AI-go-do/mspace-device/README.md

# mspace-device

M-SPACE 디바이스·센서 서비스예요. **문 앞 QR 입실**과 **방 안 재실 센서**를 맡아요.

- 담당: 수연
- 팀 공통 문서: [AI-go-do/docs](https://github.com/AI-go-do/docs) (요구사항·컨벤션·인프라)

## 1. 관련 요구사항

| ID | 내용 | 버전 |
|---|---|---|
| FR-ACC-001 | 입실 번호 확인 → 체크인 (키패드·QR 두 방식을 만들어 비교한 뒤 QR 채택, 11/10부터 QR 하나) | v0.1 |
| FR-DEV-101 | 재실 센서 값 수집 (레이더·조도·CO2 → 서버) | v0.2 |
| FR-DEV-102 | 방 현황 화면 (지금 비었는지, 다음 예약) | v0.2 |
| FR-DEV-103 | 자리 비움 자동 퇴실 (10분 비면 알림, 15분이면 퇴실. 앱의 "아직 있어요"는 예약당 1번, 누른 뒤 10분 비면 퇴실) | v0.2 |
| FR-DEV-104 | 환기 알림 (CO2 1000ppm) | 확장 (10차: 방 사용자에게 바로) |
| FR-DEV-105 | 퇴실 뒤 정리 확인 (방 카메라). 10차: 종류 구분 없이 "두고 갔다"만, 3시간 안에 안 가져가면 경고(회의는 2시간, 11/10 core #113에서 3시간) | v0.3 |
| FR-DEV-106 | 가상 에어컨·공기청정기 자동 제어 (파사드·어댑터) | v0.3 (10차) |
| FR-DEV-107 | 시나리오 시뮬레이션 (예약 → 입실 → CO2 상승 → 기기 자동 켜짐) | v0.3 (10차) |

## 2. 전체 구조

```mermaid
flowchart LR
    qr[문 앞 웹캠 QR] --> gw
    sensor[PIR · 조도] --> uno[우노]
    uno -- USB 시리얼 --> gw[중계<br/>노트북 또는 젯슨]
    gw -- HTTPS --> core[예약 서버 core]
    core -- OK / NO --> gw
    gw -- OK / NO --> uno
    uno --> led[초록 · 빨강 LED]
    radar[레이더] --> esp[ESP32<br/>메인 장치]
    esp -- 와이파이 HTTPS --> core
```

- 우노는 와이파이가 없어서 USB로 노트북에 보내고, 노트북(`gateway/gateway.py`)이 서버에 대신 전달해요.
- **ESP32가 메인 장치예요.** 노트북 없이 ESP32 → 서버로 바로 보내요. 보내는 형식이 같아서 서버는 바뀌지 않아요. 지금은 우노+젯슨(1번 방)과 ESP32(2번 방)를 같이 시험해요.
- 번호가 맞는지는 **서버만 판단**해요. 장치는 번호를 저장하지 않고, 읽은 번호를 보내고 결과를 표시만 해요.

## 3. 진행 상황 (11/11 기준)

### 지금까지 한 것

| 영역 | 한 것 | PR |
|---|---|---|
| 출입 | 키패드(#1, #25)와 문 앞 웹캠 QR(#26) 두 방식을 만들어 비교했고, 번호를 누르지 않아 더 빠르고 간편한 QR을 채택 (11/10). QR → core 확인 → 우노 LED | #1, #20–#22, #25, #26, #43, #44 |
| 재실 | PIR·조도 → `POST /api/sensor-events`, PIR 2분 유지, 방 안 카메라 인원 세기 + PIR 합치기, 조도 같이 보내기 | #24, #27, #35 |
| 정리 확인 | 퇴실 뒤 빈 방 물건 비교, 입실 직전 빈 방을 기준으로, 책상 확대·사진 비교, 이름 겹침 정리, 두고 간 물건은 종류 구분 없이 `LEFT_ITEMS` + 나중에 다시 확인, 의자 같은 가구 빼기, 책상 비교 예민도 설정(`DESK_LIGHT` 등), 바닥 확대(`FLOOR_AREA`) | #27, #28, #29, #32, #42, #47, #48, #49 |
| 정리 사진 | 사람 없는 빈 방 사진(입실 전·퇴실 뒤·다시 확인)을 core에 올리기 (`TIDY_PHOTOS=1`, 기본 꺼짐) | #51 |
| 공기 | 교육장 MQTT 센서(구독만) → 방 CO2·온도·습도, 가짜 센서(젯슨 안 브로커만)와 방 여러 개 | #33, #36 |
| 품질 재기 | 정리 확인 채점·후보 비교 도구 (정확도·심각한 오류·사진당 시간·메모리), 잘못 신고·놓침 나누기, 목표 시간 10초, 깨끗함/남음 정확도로 순위. 1~10판 결과는 9절 | #37, #45, #50, #53, #46, #52, #54 |
| 운영 | 젯슨 켜지면 자동 실행(systemd), 브라우저로 카메라 화면 보기, CI | #18, #19, #27 |
| 설계 | 가짜 센서 방마다 1대, 센서 어댑터 공통 모양 명시 | #38, #39 |

### 설계 패턴 (발표용)

```mermaid
flowchart LR
    subgraph 들어오는 값 - 어댑터
        uno[우노 PIR·조도<br/>시리얼 한 줄] --> a1[occupancy_body]
        cam[방 카메라<br/>YOLO 인원] --> a2[RoomWatcher.event]
        mqtt[실습실·가짜 센서<br/>MQTT JSON] --> a3[RoomEnv.tick]
    end
    a1 & a2 & a3 --> push[push 한 곳<br/>같은 모양] --> core[core<br/>POST /api/sensor-events]
    core2[core<br/>"2번 방 에어컨 켜"] --> facade[기기 파사드<br/>문 하나]
    subgraph 나가는 명령 - 파사드 뒤 어댑터
        facade --> v[가상 에어컨·공기청정기]
        facade -.-> lg[LG 어댑터]
        facade -.-> ss[삼성 어댑터]
    end
```

- **센서는 어댑터 패턴:** 센서마다 들어오는 모양이 달라도 어댑터가 core 이벤트 한 모양으로 바꿔요(`gateway/sensor_adapters.py`). 가짜 센서 ↔ 실습실 센서 ↔ 실제 방 센서를 설정만 바꿔 끼우고, core 코드는 그대로예요. 새 센서는 어댑터 하나 + 표 한 줄이에요.
- **기기는 파사드 패턴:** core는 파사드 하나에 명령만 보내요. 기기마다 다른 조작은 뒤의 어댑터가 맡아서, 기기 종류가 늘어도 `if LG … else if 삼성 …`이 늘지 않아요(FR-DEV-106).
- **품질은 숫자로:** 같은 시험 사진으로 모델·방법을 바꿔 가며 정확도를 재고, 채택하지 않은 후보도 9절에 남겨요.

## 4. 배선도 · 회로도

**꽂기 전에 (고장 안 나게)**
1. USB를 뽑은 상태에서 배선하고, 다 꽂은 뒤 확인하고 연결해요.
2. 5V와 GND를 직접 잇지 않아요 (합선).
3. LED는 꼭 220Ω 저항을 거쳐요. 긴 다리(+)가 핀 쪽, 짧은 다리(−)가 GND 쪽이에요.
4. D0, D1은 비워 둬요. 노트북과 시리얼로 대화하는 핀이에요.
5. 부품은 하나씩 추가하고, 추가할 때마다 시리얼 모니터로 확인해요.

**배선도** (어디에 꽂나)

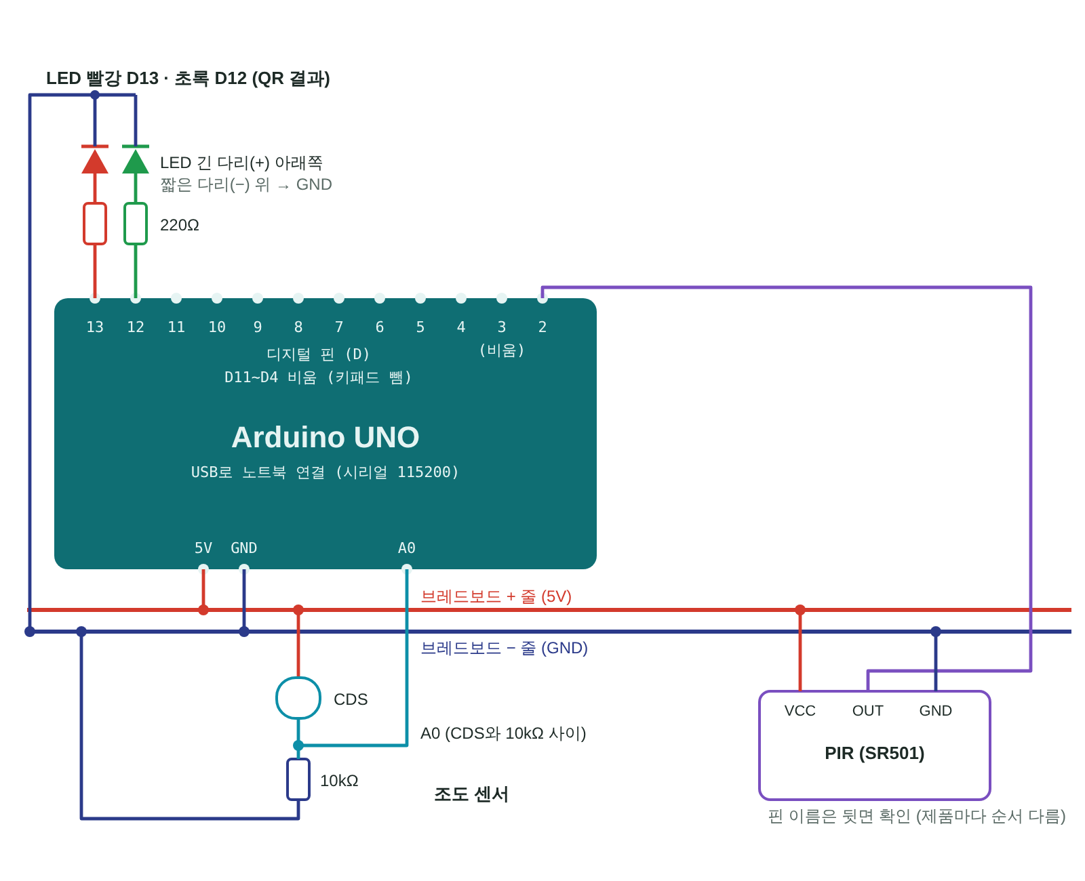
[picture p1: docs/wiring.png]
배선도


**회로도** (무엇이 무엇과 이어지나)

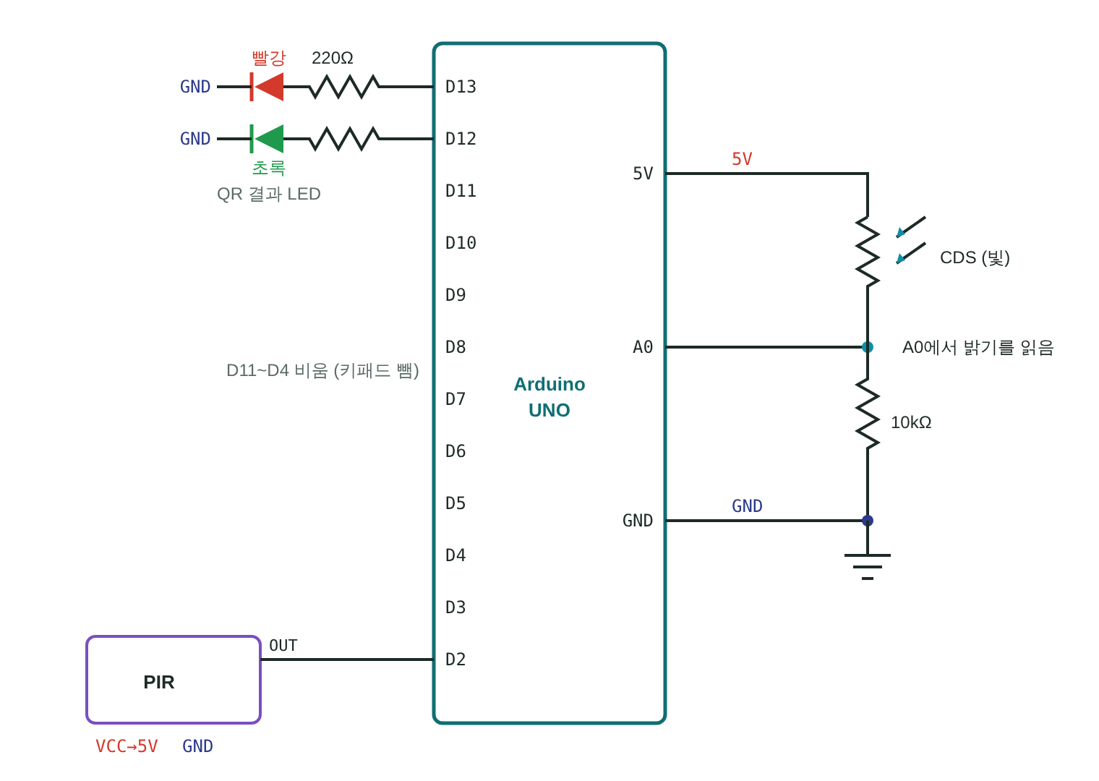
[picture p2: docs/schematic.png]
회로도


| 부품 | 우노 핀 |
|---|---|
| 초록 LED (맞음) | D12 → 220Ω → LED → GND |
| 빨강 LED (틀림) | D13 → 220Ω → LED → GND |
| PIR (SR501) | VCC → 5V, GND → GND, OUT → **D2** |
| 조도 (CDS) | 5V → CDS → **A0** → 10kΩ → GND (CDS와 10kΩ 사이를 A0에) |
| 레이더 (LD2410C) | 우노가 아니라 **ESP32**에 달아요 (아래 "ESP32 방 장치") |

D11~D4는 비워 둬요. 키패드와 QR을 비교한 뒤 QR을 채택해서 11/10에 키패드 배선을 뺐어요.

## 5. 실행 방법

1. `firmware/uno_sensor_node/uno_sensor_node.ino` 업로드 (따로 설치할 라이브러리 없음)
2. 시리얼 모니터(115200)에서 occupancy JSON이 10초마다 찍히는지 확인 → **모니터를 닫아요** (중계와 포트를 같이 못 써요)
3. 중계 실행
   ```bash
   pip3 install -r gateway/requirements.txt
   DRY_RUN=1 python3 gateway/gateway.py              # 서버 없이 테스트 (보낼 내용만 화면에)
   echo 'DEVICE_TOKEN=<받은 장치 토큰>' > .env   # 토큰은 .env에만 (저장소에 안 올라가요)
   set -a; . ./.env; set +a                          # .env 값을 불러오기
   SERVER=https://dev-mspace.java21.net python3 gateway/gateway.py   # 토큰이 실리므로 원격 서버는 https만
   SEND_SENSORS=1 SERVER=https://dev-mspace.java21.net python3 gateway/gateway.py   # 재실 센서도 core로 보내기
   ```
   재실 센서 전송(`SEND_SENSORS=1`)은 core에 `/api/sensor-events`(core #60)가 올라간 뒤 켜요. QR 확인을 막지 않게 뒤에서 보내고, 끊기거나 토큰·경로 문제(401·403·404)면 모아 뒀다가 다시 보내요(최대 360개, 약 1시간). 이벤트 자체가 틀린 것(400·409·413·422)만 버려요.
   포트는 자동으로 찾아요. 못 찾으면 `PORT=/dev/ttyACM0`처럼 지정해요.
   서버에는 `Authorization: Bearer <장치 토큰>` 헤더로 보내요. 토큰이 없으면 DRY_RUN만 돼요.
   `http://`는 내 컴퓨터에 띄운 core 테스트에서만 써요. 원격 주소에 `http://`를 쓰면 게이트웨이가 시작하지 않아요(토큰 보호).

### QR 입실 (문 앞 웹캠, 시연용)

키패드와 카메라 QR 두 방식을 모두 만들어 비교했어요. QR이 번호를 누를 필요가 없어 더 빠르고 간편해서 8차 회의(11/6)에서 **카메라 + QR**을 채택했고, 11/10에 키패드 코드를 정리했어요. 입실은 이 QR 하나로 서버 확인(`/api/access/verify`)을 해요.

```bash
ls /dev/video*                                    # 웹캠 번호 확인 (보통 0)
set -a; . ./.env; set +a
QR_CAMERA=0 SEND_SENSORS=1 python3 gateway/gateway.py          # 진짜 서버
DRY_RUN=1 QR_CAMERA=0 python3 gateway/gateway.py               # 서버 없이: 123456 QR만 초록
```

- 흐름: 폰에 QR 띄우기 → 문 앞 웹캠에 비추기 → 젯슨이 읽어 core에 확인 → 우노 LED 초록/빨강
- QR 안의 글자: 입실 번호 6자리(`123456`) 또는 방까지 넣은 `MSPACE:1:123456`. 방 번호는 `QR_ROOM_ID`(기본 1). 다른 방 QR은 서버에 묻지 않고 거부
- 지금은 예약 때 받은 6자리 번호를 QR로 만들어 비춰요 (QR 만들기 사이트나 앱). 나중에 웹 입실 화면이 QR을 바로 띄우고, core가 "30초마다 바뀌는 코드"를 주면 `qr_door.py`의 `parse_qr()`만 바꾸면 돼요
- 같은 QR을 계속 비추면 5초 동안은 다시 묻지 않아요
- **사진·영상은 저장하지도 보내지도 않아요.** 읽은 글자만 써요
- OpenCV(`cv2`)는 젯슨에 기본으로 깔려 있어요. 없다고 나오면 `sudo apt install python3-opencv`

### 방 안 카메라 (인원 세기 · 정리 확인, 시연용)

방 안을 비추는 두 번째 웹캠으로 **몇 명 있는지** 세고, 사람이 다 나가면 **방이 깨끗한지** 확인해요.

```bash
# 처음 한 번: 사람·물건 찾는 모델 받기 (yolov8s.onnx, 약 45MB)
# 작은 n(12MB)은 빠르지만 위에서 내려다본 노트북·폰을 자주 놓쳐서 s를 써요
pip3 install ultralytics && yolo export model=yolov8s.pt format=onnx opset=12
mv yolov8s.onnx gateway/

# 젯슨 기본 OpenCV(4.6)는 YOLOv8 모델을 못 읽어서 onnxruntime을 같이 써요 (처음 한 번)
sudo apt install -y python3-opencv python3-numpy python3-venv
python3 -m venv --system-site-packages ~/mspace-venv     # apt로 깐 OpenCV·serial은 그대로 씀
~/mspace-venv/bin/pip install onnxruntime

set -a; . ./.env; set +a
ROOM_CAMERA=2 YOLO_MODEL=gateway/yolov8s.onnx SEND_SENSORS=1 ~/mspace-venv/bin/python gateway/gateway.py
# 문 앞 QR과 같이: QR_CAMERA=0 ROOM_CAMERA=1 ...
# 서버 없이 화면 출력만: DRY_RUN=1 ROOM_CAMERA=1 YOLO_MODEL=gateway/yolov8s.onnx python3 gateway/gateway.py
```

**카메라 화면 보기 (설치·시연 확인용, 기본 꺼짐):** 실행 명령 앞에 `PREVIEW_PORT=8090 PREVIEW_HOST=$(tailscale ip -4)`를 붙이면 팀 Tailscale 안의 브라우저에서 `http://<젯슨 Tailscale IP>:8090`으로 카메라가 보는 화면을 볼 수 있어요. `PREVIEW_HOST`를 안 주면 젯슨 안(127.0.0.1)에서만 열려요. `PREVIEW_HOST=tailscale`이라고 써도 Tailscale 주소를 알아서 찾아요. 인증이 없어서 학교 와이파이 같은 열린 네트워크(0.0.0.0)에는 열지 않아요. 사람은 초록, 물건은 주황 상자로 그리고 사람 수를 표시해요. 젯슨 B는 8080을 다른 서비스가 쓰고 있어서 8090을 써요. 마지막 한 장만 메모리에 두고 저장·전송은 하지 않아요.

- 인원 수: 1초마다 사람 수를 세고, 최근 5번의 가운데 값을 써요(한 번 잘못 센 건 무시). 바뀌면 바로, 아니면 10초마다 기존 재실 API(`kind: OCCUPANCY`)로 보내요. `sources`에 `"people": 2`가 들어가서 **core를 안 바꿔도** 돼요
- 그 방은 카메라가 재실을 대신 보내요. **11/12부터 PIR은 안 써요(기본).** 재실은 카메라 사람 수로만 정하고, 우노는 조도만 `sources.light`로 실어요. PIR 선을 뺀 핀은 공중에 떠서 아무렇게나 1로 읽힐 수 있어서 값을 아예 버려요. 다시 쓰려면 `USE_PIR=1`: 그때는 `occupied`(사람 수 > 0 **또는** PIR)와 `sources.pir`에 합쳐요
- 정리 확인은 두 가지 방식이에요
  - **퇴실하면 확인** (`SEND_SENSORS=1`로 서버에 보낼 때): 10초마다 서버에 방 예약 상태(`GET /api/rooms/{id}/current`)를 묻고, 방금 끝난 예약(`lastEnded`)이 바뀌면 방이 10초 비었을 때 확인해요. 다 같이 화장실에 가도 예약이 안 끝났으니 확인하지 않아요. 결과는 `POST /api/rooms/{id}/tidy-checks`로 보내요. 10차부터 쓰레기든 물건이든 종류 구분 없이 남으면 `LEFT_ITEMS`, 없으면 `CLEAN`이고, `items`에 물건마다 이름(모델 이름)과 확신도를 실어요. 퇴실 직후 첫 확인(`phase: FIRST`)은 예약자에게 "두고 갔어요" 알림만 가요. 퇴실 뒤 10분 안에 방이 비지 않으면 그 예약은 건너뛰어요
  - **3시간 뒤 다시 확인** (`phase: RECHECK`, 시간은 core 설정 `mspace.tidy.recheck-after-minutes`): 첫 확인에서 남은 게 있으면, 서버가 `current`에 `recheck {reservationId, at}`를 내려 줘요. 그 시각에서 1분 더 지나고(젯슨·서버 시계 차이 여유) 방이 10초 비면 같은 기준(입실 직전 빈 방)과 개수로 다시 비교해요. 그래도 남았으면 서버가 확신도 기준(기본 0.8)으로 경고해요. 그 사이 다음 팀이 **입실하면** 서버가 `recheck`를 빼서 다시 보지 않아요(경고 없음, 예약만 잡혀 있는 동안은 계속 내려와요). 이미 기다리던 다시 확인도 취소해요. 서버가 빼기 전이라도 퇴실 뒤 카메라에 사람이 들어온 게 잡히면(예약 없이 들어온 사람, 물건 가지러 온 앞 팀 포함) 그 뒤 물건은 누구 것인지 몰라 다시 확인하지 않아요. 서버가 같은 예약의 `at`을 늦추면 새 시각을 따라요. 10분 제한은 젯슨이 다시 확인을 시작한 때(서버에서 `recheck`를 받고 시각+1분이 지난 때)부터 세요. 서버 연결이 늦게 돌아와 `at`보다 한참 뒤에 시작해도, 시작하고 10분 안에 방이 비지 않으면 건너뛰어요. 다시 확인을 기다리는 동안 방에 있는 사람의 예약 기준은 건드리지 않아요. 다시 확인은 물건 **개수**를 비교하고, VLM(`VLM_URL`)을 켰으면 입실 전 사진과 3시간 뒤 사진을 VLM에게 **다시 물어요**(11/12 수연). 그래서 경고 여부는 퇴실 직후 확률이 아니라 3시간 뒤 사진의 "새 물건 있음" 확률로 정해져요. 이를 위해 첫 확인 때 남은 게 있으면(또는 VLM에게 물었으면) VLM 크기 입실 전 사진을 다시 확인이 끝날 때까지 **젯슨 메모리에만** 둬요(파일로 안 쓰고, 젯슨 밖으로 안 나가요). 다시 확인이 끝나거나 취소되면(다음 팀 입실, 사람이 들어옴) 버려요. 책상 사진은 비교하지 않아요. VLM을 끄면 책상 사진 비교로만 찾은 물건은 그대로 있어도 `CLEAN`이 갈 수 있어요. `CLEAN`이 정리가 다 됐다는 보증은 아니에요. 다시 볼 기준·사진은 메모리에만 있어서 젯슨이 꺼지면 건너뛰어요
  - **찾으러 온 뒤 다시 확인** (11/12): 두고 간 물건을 찾으러 **찾으러 오는 QR**(core `purpose: RETRIEVE`, 10분)로 들어오면 앞 예약 다시 확인을 취소하지 않아요. QR 시각에서 `RETRIEVE_RECHECK_MIN`(기본 10, core `retrieve-pass-minutes`와 같은 값)분 뒤 방이 10초 비면 위와 같은 방법으로 다시 찍어 `RECHECK`(사진도 `TIDY_PHOTOS=1`이면)를 보내요. core는 예약마다 `RECHECK`를 한 번만 받아서 결과가 `CLEAN`이든 남음이든 이게 그 예약의 다시 확인이에요(남은 물건은 core가 처리, 문을 연 뒤라 경고·알림 없음). QR 뒤 시간이 지나도 방이 안 비면 10분 제한 없이 빌 때까지 기다려요. 그 전에 다른 QR(다음 팀 등)로 문이 열리면 지금처럼 취소해요. 찾으러 온 사람이 들어오기 직전 빈 방(두고 간 물건이 찍힘)은 다음 예약 기준으로 쓰지 않아요. 문 QR과 방 카메라가 같은 게이트웨이에서 돌 때만 돼요
  - **입실 전 사진은 실제 입실 직전 빈 방** (11/12, #39): 퇴실 뒤 처음 문이 열리면(QR·키패드, 찾으러 온 QR 빼고) 그 뒤 처음 사람이 보일 때 그 직전 빈 방으로 기준을 다시 잡아요. 그래서 퇴실 뒤 치우러 잠깐 들어갔다 나온 것은 기준이 안 돼요. 입실 뒤 화장실 다녀와 문을 다시 열 때는 처음 기준을 그대로 둬요. QR이 처리되기 직전에 카메라가 사람을 먼저 봐서 빈 방 후보를 못 쓴 경우에도, 그 후보를 15초(`HELD_SNAPSHOT_SEC`) 들고 있다가 QR 입실이면 그것으로 기준을 잡아요
    - **젯슨을 다시 켰을 때** (11/12, 예약 47): 파일에서 불러온 예전 기준은 **다음에 사람이 들어올 때 무조건 새로 잡아요**(QR이 없어도). 예전 기준을 그대로 쓰다 그 안의 가짜 노트북 때문에 두고 간 노트북을 놓쳤어요. 대신 예약 중에 젯슨을 다시 켜고 그 뒤 화장실에 다녀오면 그때 책상(그 팀 물건 포함)이 기준이 돼요. 불러온 기준으로 확인할 때도 저장된 입실 전 사진(`TIDY_PHOTOS=1`)으로 VLM 사진을 만들어 **VLM에게 꼭 물어요**
  - 확신도 = **이 사진 두 장에서 새 물건이 정말 있을 확률** (11/12 수연). VLM이 답했으면 물건마다 YOLO 점수와 VLM이 "새 물건 있음"이라 할 확률(첫 단어 YES/NO 후보 확률) 중 **높은 값**을 써요. YOLO 점수가 없는 물건(책상 비교로만 찾음)은 VLM 확률이에요. (11/12 수연: 예약 #51에서 VLM은 없다 24%, YOLO는 마우스 71%로 "남음"인데 24%로 보여서 바꿈) VLM 답이 없으면(VLM 꺼짐, 시간 초과, 젯슨을 다시 켜서 입실 전 사진이 없음) YOLO 점수(같은 종류 중 낮은 쪽), 그것도 없으면 0.5(알림만). 채점 표 값은 붙이지 않아요
  - **시험 점수 같이 보내기 (#63)**: 지금 설정과 같은 설정으로 채점한 가장 최근 점수를 결과에 `model {setup, accuracy, cases, secondsPerPhoto, measuredAt}`로 같이 보내요(숫자만, 사진·문제 이름은 안 보냄). 관리자 화면의 "모델 시험 정확도"용이에요. 채점 기록 파일은 `TIDY_RESULTS`(기본 `eval/tidy/results.jsonl`, 끄려면 `off`). 문제집을 `~/AI-go-do`에 두면 `TIDY_RESULTS=$HOME/AI-go-do/results.jsonl`을 붙여요. VLM을 켰으면 같은 VLM 모델로 채점한 기록만 써요
  - **예약 기준 (입실 직전 빈 방, docs Q-22 B안)**: 퇴실 모드는 처음 깨끗한 방이 아니라 **사람이 처음 보이기 직전의 빈 방**과 비교해요. 한 장씩 셌을 때 0명이 연속 3초면 그 모습을 메모리에 들고 있다가(빈 방이 계속되면 1분마다 새로), 사람이 **10초 넘게 이어서** 보이면 그 예약의 기준으로 확정해요(`예약 기준 저장 1번 방: …`, `ENTRY_PERSON_SEC`). 문 밖을 지나가는 사람이 몇 초 찍힌 것으로는 "들어왔다"고 보지 않아서, 앞 예약 다시 확인도 취소되지 않아요(11/12 예약 51). 그래서 앞 팀이 두고 간 물건을 다음 팀 탓으로 하지 않아요. QR 없이 들어와도 똑같이 잡혀요
    - 화장실 등으로 다 같이 나갔다 오면 처음 기준을 그대로 둬요
    - 카메라엔 0명인데 PIR이 10초 넘게 켜져 있다가 사람이 보이면(카메라에 안 보인 사람이 뭘 두었을 수 있음) 그 후보는 쓰지 않아요. 문 열 때 PIR이 1~2초 먼저 켜지는 건 보통 입실로 봐요
    - 앞 팀 퇴실을 안 뒤 방이 3초는 비었지만 10초 전에 다음 팀이 들어오면, 앞 팀 확인은 건너뛰고 그 빈 방이 다음 팀 기준이 돼요
    - 방이 한 번도 안 비어 기준이 없으면 결과를 보내지 않아요(`건너뜀 - … 기준이 없어`). 이 경우는 다음 팀의 어질러짐 신고(입실 뒤 5분, 입실 사진)가 받아요
    - `room_baseline_entry.json`(물건 개수)과 `DESK_PHOTO`일 때 `room_baseline_entry_desk.png`에 적어 두어 껐다 켜도 이어지고, **그 예약 정리 확인이 끝나면 지워요**
  - **연습 모드** (`DRY_RUN=1`): 서버 없이, 사람이 있다가 다 나가고 30초가 지나면 확인하고 화면·기록 파일에만 남겨요
- 판정: 기준(퇴실 모드는 입실 직전 빈 방, 연습 모드는 처음 본 빈 방)과 종류별 개수로 비교해서(자리는 안 봐서 조금 옮겨도 괜찮아요) 장치 안에서는 늘어난 컵·병 같은 쓰레기를 `NEEDS_CLEANING`, 노트북·가방·폰 같은 물건을 `LEFT_ITEMS`로 나눠 화면·기록에 보여 줘요. 서버로는 10차대로 둘 다 `LEFT_ITEMS`(두고 감) 하나로 합쳐 보내고, 없으면 `CLEAN`이에요
- 방 비품: `ROOM_ITEMS=remote:1` 처럼 주면 그 개수까지는 있어도(책상 위) 없어도(바구니 안) 괜찮다고 봐요. 여러 개는 `remote:1,book:3`
- **공간 등록 (자동, 새 방에서 처음 켤 때)**: 방 비품을 손으로 적지 않아도 돼요. `ROOM_ITEMS`를 안 주고 게이트웨이를 켜면, 젯슨에 `room_profile.json`이 없을 때 **처음 빈 방 5분 동안 혼자 등록**하고 그대로 계속 돌아요. 사람이 들어오면 멈췄다가 다시 비면 이어서 세요. 다시 등록하려면 `room_profile.json`을 지우고 게이트웨이를 다시 켜요. 게이트웨이 없이 따로 해 보려면 `ROOM_CAMERA=2 YOLO_MODEL=gateway/yolov8s.onnx TILE_GRID=3 ~/mspace-venv/bin/python gateway/room_setup.py`
  - 빈 방을 10초마다 한 장씩, 5분어치(30장) 정리 확인과 같은 방법으로 물건을 세요. 사람이 보이는 장은 안 써요
  - 쓸 수 있는 장의 80% 이상에서 보인 물건만 비품이 돼요. 한두 장에서 잘못 본 것은 빠져요. 컵·종이 같은 치울 것이 계속 보이면 등록하지 않고 다음 빈 방 때 처음부터 다시 해요
  - 결과는 젯슨의 `room_profile.json`(`ROOM_PROFILE`)에만 써요. 사진은 저장하지 않고 서버로도 안 보내요. 게이트웨이는 `ROOM_ITEMS`를 안 주면 이 파일의 비품을 써요 (`ROOM_ITEMS`를 주면 그게 먼저, `ROOM_PROFILE=off`면 안 읽음)
  - 등록되는 건 YOLO가 이름을 아는 물건(리모컨·책·키보드 …)뿐이에요. 휴지·펜처럼 YOLO가 모르는 물건은 등록도 안 되고 YOLO 개수로 세지지도 않아요 (사진 비교는 입실 직전 사진과 비교해서 그대로 있으면 안 잡힘). 10장마다 `공간 등록: 10장째 / 30장`처럼 진행을 보여 줘요
  - 정확도를 올리는 기능이 아니라 새 방 설치 때 손으로 할 일을 줄이는 기능이에요. 의자 위 물건 확인 같은 건 아직 안 들어 있어요
- 깨끗한 방 기준: 기준이 없으면 켠 뒤 처음 0명일 때 저장하고 `깨끗한 방 기준 저장 1번 방: 물건 N개`를 띄워요. `room_baseline.json`에 적어 두어서 **껐다 켜도 남아요** (켤 때 `저장된 깨끗한 방 기준 불러옴`). 다시 찍으려면 `rm room_baseline.json` 하고 다시 켜요. 파일 없이 메모리에만 두려면 `BASELINE_FILE=off`. 기준이 없을 때 퇴실하면 결과 대신 그때 모습을 기준으로 저장해요
- 기준 저장·정리 확인 때만 화면을 4조각으로 나눠 자세히 봐요(멀리 있는 폰 같은 작은 물건). 그 한 번만 5배 느리고 평소 인원 세기 속도는 그대로예요
- **조각 수 (`TILE_GRID`, 기본 2)**: `TILE_GRID=3`이면 4조각 대신 9조각(가로·세로 3줄, 조각 하나 = 화면의 1/3 × 1.1, 옆 조각과 겹침)으로 봐요. 물건이 더 크게 보여서 책상 상자(`DESK_AREA`) 없이도 작은 물건을 볼 수 있는지 재려고 만들었어요(11/12 수연: 방마다 상자를 맞추지 않고 어느 장소에서든). 한 장보다 10배 느려요. 2~4만 돼요
- **책상 확대 (`DESK_AREA`)**: 카메라가 방 전체를 위에서 찍으면 책상 위 물건이 너무 작아요. `DESK_AREA=0.25,0.22,0.64,0.83`(화면 왼쪽 위 x,y · 오른쪽 아래 x,y 비율)을 주면 정리 확인 때 책상만 잘라 한 번 더 봐요. 미리보기에 하늘색 `desk` 상자로 보여서 책상에 맞게 고치면 돼요
- **바닥 확대 (`FLOOR_AREA`, 기본 꺼짐)**: 가방·에어팟 케이스·틴트처럼 바닥에 떨어진 물건도 작아서 놓쳐요. `FLOOR_AREA=x1,y1,x2,y2`(같은 비율 모양)를 주면 정리 확인 때 바닥 부분도 잘라 한 번 더 봐요. 미리보기에 `floor` 상자로 보여요. 책상 사진 비교는 책상(`DESK_AREA`)만 해요
- **책상 사진 비교 (`DESK_PHOTO=1`, 기본 꺼짐)**: 모델(80종)은 위에서 본 종이·보조배터리·카드·과자 봉지를 못 알아봐요. 켜면 사람 0명일 때 깨끗한 책상 사진 한 장을 젯슨에만 두고(`room_baseline_desk.png`, 책상 부분만 흑백·작게, 서버로 안 보냄), 퇴실 뒤 책상과 비교해 **달라진 곳**을 찾아요
  - 달라진 곳에는 모델을 한 번 더 돌려 이름을 붙여요. 이름이 붙으면 두고 간 물건(휴대폰·보조배터리 …)이나 치울 것(컵·종이 …)으로, 안 붙으면 `모르는 물건`(치울 것)으로 봐요 → 서버로는 `LEFT_ITEMS`로 가요. 확신도는 VLM이 "새 물건 있음"이라 한 확률이고, VLM 답이 없으면 0.5예요(아래 "확신도" 참고). 첫 확인은 알림만 가요
  - 모델이 이미 찾은 물건, 깨끗할 때 있던 물건(리모컨)을 옮겨서 생긴 빈자리는 빼요. 조명이 조금 바뀌는 건 밝기를 맞춰서 무시하고, 책상 대부분이 바뀌면(카메라가 움직임) 비교를 건너뛰어요. 깨끗하면 사진을 새로 찍어 햇빛 변화를 따라가요
  - 예민한 정도는 설정으로 바꿔요: `DESK_LIGHT=local`(블라인드·문틈 빛처럼 한쪽만 밝기가 바뀐 것을 지우고 비교, 기본 `mean`은 전체 밝기만 맞춤) 또는 `DESK_LIGHT=ssim`(밝기 대신 자리마다 모양이 달라졌는지 비교, 빛·그림자에 가장 덜 예민), `DESK_THRESH`(밝기 차이 기준, 기본 35, 높을수록 덜 예민), `DESK_MIN_AREA`(이보다 작은 차이는 무시, 책상 넓이 비율, 기본 0.0012), `DESK_MOVE=1`(원래 있던 리모컨을 옮기거나 뒤집은 것, 기준 때 다른 이름의 물건이 있던 자리에 비슷한 크기로 잡힌 것은 새 물건으로 안 셈. `DESK_MOVE_SAME` 기본 1.0, 높을수록 덜 뺌)
  - 화면 전체를 비교할 때(`DESK_AREA=0,0,1,1`, 11/12): `DESK_KEEP_SMALL`(화면이 35% 넘게 달라져도 비교를 건너뛰지 않고, 화면 넓이의 이 비율보다 작은 변화만 봄. 기본 0 = 예전처럼 건너뜀), `DESK_FURNITURE_SMALL`(달라진 곳이 "의자" 같은 가구로 이름 붙어도, 그 가구 상자의 이 비율보다 작으면 의자 위·옆에 둔 물건으로 셈. 기본 0 = 예전처럼 가구로 보고 뺌)
  - 가구 이름 다시 확인 (`DESK_FURNITURE_SEEN=1`, 기본 꺼짐, 12판 1등 89.4%): 달라진 조각에 "의자" 같은 가구 이름이 붙어도, 화면 전체에서 모델이 그 자리에 그 가구를 못 찾았으면 `모르는 물건`으로 세요. 진짜 의자가 보이는 자리는 예전처럼 빼요 (의자 위 가방은 이걸로 안 풀려요)
- **VLM으로 한 번 더 보기 (`VLM_URL`, 기본 꺼짐, 10판 1등 87.2%)**: 퇴실 뒤 첫 확인 때와 3시간 뒤 다시 확인 때 입실 전 사진과 지금 사진 두 장을 젯슨 안 VLM(Qwen3-VL-2B, llama.cpp)에게 보여 주고 "새로 생긴 물건이 있나?"를 물어요. `VLM_RULE=or`(기본)면 YOLO가 깨끗하다 해도 VLM이 있다고 하면 `unknown` 1개(확신도 = VLM이 YES라 한 확률)로 보내요
  - 사진은 젯슨 밖으로 안 나가요: `VLM_URL`은 `127.0.0.1`만 받고, 입실 전 사진은 메모리에만 둬요 (젯슨이 꺼졌다 켜지면 그 예약은 YOLO 결과만)
  - 한 번에 30초쯤 걸려서 따로 묻고, 그동안 인원 세기는 계속돼요. VLM 서버가 꺼져 있거나 답을 못 하면 YOLO 결과 그대로 보내요
  - 젯슨에서 먼저 VLM 서버를 켜요 (다른 터미널, 메모리 약 2.3GB): `~/llama.cpp/build/bin/llama-server -m ~/vlm/Qwen3-VL-2B-Instruct-Q8_0.gguf --mmproj ~/vlm/mmproj-Qwen3-VL-2B-Instruct-Q8_0.gguf --host 127.0.0.1 --port 8091 -t 6 -c 8192`
  - 10판 1등과 같은 설정: `DESK_PHOTO=1 DESK_LIGHT=ssim DESK_THRESH=25 DESK_MOVE=1 VLM_URL=http://127.0.0.1:8091`
  - VLM은 기다림이 90초를 넘으면 YOLO 결과만 보내요 (채점은 300초). VLM 요청은 프록시를 거치지 않아요 (#62)
  - 채점 때 `VLM_CACHE=$HOME/AI-go-do/vlm_cache.json`을 붙이면 VLM 답을 젯슨 안에 적어 두어, 같은 사진·모델이면 다음 채점에서 다시 묻지 않아요 (47쌍이 몇 분)
  - 이름 붙이기를 더 잘하려면 우리 물건 이름을 넣은 YOLO-World 모델을 만들어 `LABEL_MODEL=gateway/yolov8s-worldv2.onnx`로 줘요 (`tools/export_world.py`, 맥에서 한 번)
  - 사진을 젯슨에 두는 것이라 팀 회의에서 정한 뒤 켜요 (퇴실·신고 사진처럼 **사람 없는 방**만)
- 깨끗한 방 찍는 법: 물건을 다 치우고 `rm room_baseline.json`, 사람이 카메라 밖으로 나간 뒤 프로그램을 켜요 (자동 실행이면 `sudo systemctl restart mspace-gateway`) → 위 문구가 뜨면 들어와도 돼요
- 결과는 화면에 출력하고 `room_checks.jsonl`에도 한 줄씩 남겨요 (사진 없이 글자만)
- 방 번호는 `ROOM_CAMERA_ROOM`(기본 1), 카메라 번호는 `ROOM_CAMERA`. 웹캠 하나에 번호가 여러 개 잡히니 `v4l2-ctl --list-devices`로 확인해요 (11/6 젯슨 B: C920=0 문 앞, BRIO=2 방 안)
- 모델이 없으면 OpenCV 기본 사람 찾기(HOG)로 사람 수만 세요. 정리 확인은 꺼져요
- **사진·영상은 저장하지도 보내지도 않아요** (아래 `TIDY_PHOTOS=1`을 켰을 때의 빈 방 사진만 빼고). 한 장 보고 바로 지우고, 숫자와 물건 이름만 남겨요. `DESK_PHOTO=1`을 켰을 때만 사람 없는 책상 사진(깨끗한 방 1장 + 예약 기준 1장)을 젯슨 안에 두고, 예약 기준 사진은 그 예약 정리 확인 뒤 지워요 (docs v0.4.26)
- **정리 확인 사진 올리기 (`TIDY_PHOTOS=1`, 기본 꺼짐, docs Q-27 v0.4.39)**: 퇴실 모드에서 사람 0명인 빈 방 컬러 사진을 core(`POST /api/rooms/{방}/tidy-photos`, 30일 보관)에 올려 관리자 화면에서 볼 수 있게 해요
  - 입실 전(`ENTRY`, 예약 기준과 같은 순간) · 퇴실 뒤(`FIRST`) · 3시간 뒤(`RECHECK`) 3장. 결과(`tidy-checks`)를 보낸 다음에 올려요
  - 빠르게 센 것·자세히 찾은 것 어디에든 사람이 보이면 그 장은 안 올려요. 긴 변 1280px JPEG, 1MB 아래로 줄여요
  - **물건 자리 빨간 동그라미 (11/13)**: 퇴실 뒤·3시간 뒤 사진에는 남았다고 본 물건 자리마다 빨간 타원을 그려 올려요. YOLO가 찾은 물건은 그 상자, 책상 사진 비교로 찾은 곳은 달라진 상자예요. 같은 이름이 입실 전보다 늘었으면 확신도와 같은 쪽(점수 낮은 것부터 늘어난 개수만)에 그리고, 옮기거나 뒤집은 비품(`DESK_MOVE`)으로 뺀 것과 깨끗함일 때는 안 그려요. VLM만 "남음"이라 한 경우는 자리를 몰라 동그라미가 없어요. 입실 전 사진·VLM에 보내는 사진·결과(`tidy-checks`)에는 안 넣어요
  - 입실 전 사진은 퇴실 확인 때까지만 `room_baseline_entry.jpg`에 두고(껐다 켜도 이어짐) 보내면 지워요. 기록 파일(`room_checks.jsonl`)엔 사진을 안 남겨요
  - core가 `ENTRY`를 아직 안 받으면(400) 그 장만 버리고 나머지는 그대로 가요. 이미 올렸거나(409) 다른 예약이면 버리고, 서버 문제·연결 실패면 다시 보내요
- **우노 없이 카메라만**: 우노가 안 꽂혀 있어도 `QR_CAMERA`나 `ROOM_CAMERA`를 켜면 카메라만 돌아가요. QR 결과는 LED 대신 화면에 "초록(열림)/빨강(거부)"로 나와요

#### 정리 확인 채점 (후보 비교)

정리 확인이 얼마나 맞는지 숫자로 재요. 정답을 적은 **시험 사진 쌍**(입실 전 빈 책상 + 퇴실 뒤)을 모아 두고, 설정(후보)을 바꿔 가며 같은 문제로 채점해요. 목표는 **정확도 (깨끗함/남음) 95% 이상, 심각한 오류 0, 사진당 2분 안**이에요. 퇴실 뒤 한 번만 보니까 시간보다 정확도가 우선이에요 (11/11에 10초 → 2분으로 바꿈).

```bash
# 1) 시험 사진 찍기 (젯슨, 사람이 화면에 보이면 저장 안 함). 질문에 Enter, 정답 번호, 메모를 넣어요
ROOM_CAMERA=2 YOLO_MODEL=gateway/yolov8s.onnx ~/mspace-venv/bin/python gateway/tidy_eval.py capture ~/AI-go-do
# 2) 채점 (게이트웨이와 같은 설정 이름). 후보를 바꿔 여러 번 돌려요
YOLO_MODEL=gateway/yolov8s.onnx ~/mspace-venv/bin/python gateway/tidy_eval.py score ~/AI-go-do
YOLO_MODEL=gateway/yolov8s.onnx DESK_PHOTO=1 DESK_AREA=0.25,0.22,0.64,0.83 ~/mspace-venv/bin/python gateway/tidy_eval.py score ~/AI-go-do
```

- 문제집은 폴더를 안 주면 `eval/tidy/`에 쌓여요 (젯슨 B는 `~/AI-go-do`, 위 명령처럼 맨 뒤에 폴더를 줘요. 그 폴더를 기본으로 두었다면 생략해도 돼요): `001/before.jpg`, `001/after.jpg`, `answers.csv`(정답 `CLEAN` / `NEEDS_CLEANING` / `LEFT_ITEMS`와 메모). 사람 없는 책상 사진만, **젯슨 안에만** 두고 git(`.gitignore`)·서버에는 안 올려요
- 깨끗한 문제도 꼭 섞어요(잘못 신고 검사). 쓰레기 종류·자리·조명을 바꿔 가며 30~50개
- 판정은 퇴실 모드와 같아요: `before`를 그 예약의 기준으로 보고 `after`에서 늘어난 것만 봐요
- **심각한 오류**: 깨끗한데 치울 것·두고 감으로 봄(죄 없는 예약자 신고), 치울 것·두고 감이 있는데 깨끗함으로 봄(다음 팀이 더러운 방을 받음). 치울 것 ↔ 두고 감끼리 바뀐 건 틀림이지만 심각하진 않아요(어느 쪽이든 관리자가 봐요)
- 채점하면 정확도·심각한 오류·시간, 틀린 문제와 그때 찾은 것을 보여 주고, 아래 **실험 기록** 표에 붙일 한 줄을 만들어 줘요. 매번 채점한 문제집 폴더의 `results.jsonl`에도 남아요 (예: `~/AI-go-do/results.jsonl`, 폴더를 안 주면 `eval/tidy/results.jsonl`)
- **동그라미 사진 보기 (`TIDY_MARKS=1`, 11/13)**: `score`에 붙이면 문제마다 입실 전 | 퇴실 뒤 사진을 나란히 놓고, 퇴실 뒤에는 게이트웨이와 똑같이 남았다고 본 자리에 빨간 동그라미를 그려 `[문제집]/marks/문제.jpg`로 저장해요. 위 줄에 정답·판정·동그라미 수(초록 = 맞음, 빨강 = 틀림)가 있고, `marks/index.html`은 틀린 문제부터 보여 줘요. 젯슨 안에만 두고 tailscale로만 봐요(`python3 -m http.server 8092 --bind <tailscale IP> --directory ~/AI-go-do/marks`). 기록 파일·core에는 안 남아요
- 결과는 core로도 올라가 관리자 화면(기록 > 정리 확인 > 오디 AI 상자 "모델 시험 정확도")에 보여요. `score`가 끝나면 숫자만(깨끗함/남음 정확도·세 가지 정확도·문제 수·심각 오류·사진당 시간 중간값·채점 시각) `POST /api/rooms/{ROOM_CAMERA_ROOM}/model-scores`로 보내고, 사진·문제 이름·설정은 안 보내요. 게이트웨이처럼 `.env`를 읽고(`(set -a; . ./.env; set +a; SERVER=https://… … tidy_eval.py score ~/AI-go-do)`, `push-last`도 같게) `SERVER`를 붙여 돌릴 때만 보내고, `SERVER`가 없거나 `DRY_RUN=1`이면 보낼 내용만 찍어요. 실패해도 채점 기록은 그대로고, `tidy_eval.py push-last ~/AI-go-do`로 마지막 결과를 다시 보낼 수 있어요(같은 eventId라 core는 한 번만 저장). `compare`는 후보마다 보내지 않고, `push-last`도 compare 후보 줄은 건너뛰어요
- 설정을 맞추는 데 쓴 사진과 채점 사진은 나눠요. 같은 사진으로 맞추고 채점하면 점수가 실제보다 높게 나와요

**여러 후보를 한 번에 비교 (`compare`)**: `eval/tidy/candidates.txt`에 후보를 한 줄에 하나씩 적고 돌리면, 후보마다 따로 띄워 채점해서 한 표로 보여 줘요.

```text
# eval/tidy/candidates.txt  (이름 | 게이트웨이와 같은 설정)
v8n          | YOLO_MODEL=gateway/yolov8n.onnx
v8s (지금)   | YOLO_MODEL=gateway/yolov8s.onnx
v8s + 책상   | YOLO_MODEL=gateway/yolov8s.onnx DESK_PHOTO=1 DESK_AREA=0.25,0.22,0.64,0.83
```

```bash
~/mspace-venv/bin/python gateway/tidy_eval.py compare
```

| 칸 | 뜻 |
|---|---|
| 판단 | 채택(기준을 넘은 것 중 가장 좋음) / 후보(기준 넘음) / 탈락(못 넘은 기준) / 실패(모델 파일 없음 등) |
| 정확도 (깨끗함/남음) | 깨끗한지, 뭔가 남았는지만 맞으면 정답. 사용자에게는 쓰레기와 두고 간 물건을 구별하지 않고 알려서 순위·합격은 이 점수로 정해요 (11/11부터) |
| 세 가지 정확도 | 쓰레기인지 두고 간 물건인지까지 맞힌 비율, 그리고 정답별(깨끗함 / 치울 것 / 두고 감). 참고용 |
| 심각 오류 · 사진당 시간 | 위 기준과 같음. 시간은 중앙값(최대) |
| 메모리 최대 · 모델 올리기 | 젯슨에서 그 후보가 쓴 메모리(GPU 포함), 모델을 불러와 첫 장을 보기까지 걸린 시간 |
| 라이선스 | 모델 파일 이름으로 알려 줘요. YOLOv8·YOLO11·YOLO-World는 AGPL-3.0이라 배포할 땐 확인이 필요해요 |

표는 `eval/tidy/compare_<날짜>.md`에도 저장돼요. 아래 실험 기록에 붙여요. 한 후보가 `TIDY_TIMEOUT`(초) 안에 안 끝나면 실패로 두고 다음 후보로 넘어가요. 기본은 문제 수 × 2장 × 2분 + 10분(최소 30분)이라, 47쌍이면 약 3시간 18분이에요.

### 교육장 MQTT 센서 → 방 CO2·온도·습도 (시연용, 기본 꺼짐)

실습실에 이미 있는 센서(CO2·온도·습도)를 M-SPACE 방으로 치고 써요 (docs Q-21). 젯슨이 교육장 MQTT를 **구독만** 하고, 고른 공간 센서들의 평균을 1분마다 core `POST /api/sensor-events`(`kind: CO2` + `temperatureC`·`humidityPct`)로 보내요. 실제 방에 센서를 달면 설정만 바꾸면 돼요.

```bash
~/mspace-venv/bin/pip install "paho-mqtt>=2.0,<3"   # 처음 한 번
# .env에 (저장소에 안 올라가요, 채팅·코드에 쓰지 않기)
#   MQTT_HOST=…  MQTT_USERNAME=…  MQTT_PASSWORD=…
set -a; . ./.env; set +a
MQTT_ROOM=1 SEND_SENSORS=1 ~/mspace-venv/bin/python gateway/gateway.py   # 카메라 설정은 평소처럼 같이 붙여요
```

| 설정 | 기본 | 뜻 |
|---|---|---|
| `MQTT_ROOM` | 끔 | 이 방 번호로 보내요. 비우면 MQTT를 안 켜요 |
| `MQTT_LOCATION` | `실습실` | `deviceInfo.tags.location`이 이 값인 센서만 써요 |
| `MQTT_HOST` · `MQTT_PORT` | · `1883` | 교육장 브로커 (TLS 없음) |
| `MQTT_USERNAME` · `MQTT_PASSWORD` | 없음 | `.env`에만. 비밀번호는 화면에도 안 찍어요 |
| `MQTT_CLIENT_ID` | `mspace-<젯슨 이름>-reader` | 다른 사람과 겹치면 서로 끊겨요 |
| `MQTT_DEVICE_ID` | `sensor-<방 번호>` | core에 보내는 장치 이름. 장치별 토큰이면 core에 등록된 이름이어야 해요(아니면 403) |

- 토픽 `application/+/device/+/event/up` (ChirpStack 업링크), QoS 1, `clean_session=False`, keepalive 30 → 잠깐 끊겨도 그동안 온 메시지를 받아요. 끊기면 1~5초 간격으로 다시 붙어요
- 게이트웨이 2대가 같은 메시지를 보내서 `(devEui, fCnt)`가 같으면 한 번만 써요
- 센서 시각이 받은 시각보다 30초 넘게 미래면 받은 시각을 써요
- 공간 평균은 **기기마다 최근 값 하나**를 먼저 고른 뒤 내요(실습실 9대 넘음). 5분 넘게 안 온 기기는 빼요(주기 1~2분)
- 새 값이 온 분에만 보내요. 같은 값을 다시 보내면 core의 "1000ppm 3분 연속 → 환기 알림"이 옛 값으로 늘어나서요
- 형식이 안 맞는 메시지는 건너뛰고 로그로 남겨요. 센서마다 처음 한 번 `object`에 온 키(co2·tvoc·pressure 등)를 찍어요
- **주의**: 실습실 CO2가 1000ppm을 3분 넘기면 그 시간 1번 방 예약자에게 진짜 환기 알림이 가요(30분에 한 번)

#### 진짜 센서가 멈췄을 때: 가짜 센서로 시연

교육장 센서 값이 브로커에 안 들어올 때(정전 뒤 등) 쓰는 방법이에요. 젯슨 **안에** 우리만 쓰는 브로커를 켜고, 가짜 센서가 방마다 진짜와 같은 모양의 값을 1분마다 올려요. 교육장 공용 브로커에는 절대 올리지 않아요(코드가 `localhost`가 아니면 멈춰요).

```bash
sudo apt install -y mosquitto        # 한 번만. 젯슨 안에서만 열려요 (localhost)
# 터미널 1: 가짜 센서
cd ~/mspace-device && FAKE_ROOMS=1,2,3 ~/mspace-venv/bin/python gateway/fake_env_sensors.py
# 터미널 2: 게이트웨이 (평소 명령 앞에 두 개만 바꿔 붙임)
cd ~/mspace-device && set -a; . ./.env; set +a
MQTT_HOST=localhost MQTT_ROOMS=가상-1:1,가상-2:2,가상-3:3 SEND_SENSORS=1 QR_CAMERA=0 ROOM_CAMERA=2 \
  YOLO_MODEL=gateway/yolov8s.onnx ~/mspace-venv/bin/python gateway/gateway.py
```

- 방마다 센서 1대, 사람 수가 몇 분마다 바뀌고 그에 따라 CO2·온도·습도가 천천히 움직여요
- CO2는 `FAKE_CO2_MAX`(기본 950)를 넘지 않아요. 1000ppm 3분 연속이면 서버가 실제 예약자에게 환기 알림을 보내서요
- `MQTT_ROOMS`는 `공간 이름:방 번호`를 쉼표로 이어요. 진짜 센서로 돌아갈 때는 `MQTT_HOST`·`MQTT_ROOMS`를 빼고 평소처럼 켜요
- 방마다 core에 `sensor-<방 번호>`로 보내요. `막힘(403 …)`이 뜨면 그 장치 이름이 서버에 등록돼 있는지 확인해요

### 젯슨 켜지면 자동 실행 (systemd)

SSH가 끊기거나 젯슨을 껐다 켜도 게이트웨이가 알아서 다시 켜져요. 처음 한 번만:

```bash
cd ~/mspace-device
bash deploy/install-service.sh        # gateway.env를 만들고(없으면) 서비스로 켬. sudo 비밀번호를 물어요
nano gateway.env                      # 설정 확인 (카메라 번호, DRY_RUN 등). 고쳤으면 아래 restart
```

- 화면 출력은 전처럼 `tail -f gateway.log`로 봐요
- 설정 바꾼 뒤: `sudo systemctl restart mspace-gateway` / 끄기: `sudo systemctl stop mspace-gateway` / 상태: `systemctl status mspace-gateway`
- 꺼지면 5초 뒤 다시 켜요. 자동 실행을 아예 없애려면 `bash deploy/install-service.sh remove`
- 설정은 `gateway.env`, 토큰은 `.env`에 두고 둘 다 저장소에 안 올라가요. `gateway.env`에선 `$(tailscale ip -4)`를 못 써서 `PREVIEW_HOST=tailscale`로 쓰면 Tailscale 주소를 알아서 찾아요 (켜질 때 최대 1분 기다림)
- 손으로 켜서 시험할 땐 먼저 `sudo systemctl stop mspace-gateway` (카메라를 둘이 같이 못 써요)

### 젯슨에서 올리기 (맥 IDE가 안 될 때)

```bash
~/bin/arduino-cli compile -b arduino:avr:uno firmware/uno_sensor_node
~/bin/arduino-cli upload -p /dev/ttyUSB0 -b arduino:avr:uno firmware/uno_sensor_node
```
호환 우노(CH340 칩)는 `ch341` 드라이버가 필요해요. 재부팅해도 켜지게 하려면 한 번만:
```bash
sudo mkdir -p /lib/modules/$(uname -r)/kernel/drivers/usb/serial
sudo cp ~/ch341/ch341.ko /lib/modules/$(uname -r)/kernel/drivers/usb/serial/
sudo depmod -a
echo ch341 | sudo tee /etc/modules-load.d/ch341.conf
```

### 재실 센서 확인 (PIR · 조도)

11/12부터 PIR은 빼고 조도만 써요. 아래 PIR 확인은 `USE_PIR=1`로 다시 켤 때만 해당해요. PIR을 안 쓸 때는 `재실 1번 방 조도: 512 (PIR 안 씀, …)` 줄이 10초마다 떠요.

1. PIR 뒤 주황 손잡이: 시간(Tx)은 제일 짧게, 감도(Sx)는 가운데. 점퍼는 **H**(움직이는 동안 계속 켜짐). L이면 움직여도 있음↔없음이 반복돼요
2. 켜고 **1분쯤** 기다려요. PIR은 켜진 직후 1분 정도 값이 들쭉날쭉해요
3. `USE_PIR=1 DRY_RUN=1 python3 gateway/gateway.py` 실행 후
   - 손을 흔들면 `재실 1번 방: 있음 (pir=1, ...)`. 그 뒤 가만히 있어도 **2분 동안은 있음**이에요 (`PIR_HOLD_MS`). PIR은 움직임만 봐서, 공부하며 가만히 있는 사람을 "없음"으로 보지 않게 한 거예요
   - 조도 센서를 손으로 가리면 `조도=` 숫자가 작아져요
   - 가만히 두어도 10초마다 한 줄씩 나와요 (살아 있다는 신호)
4. `[DRY_RUN] POST /api/sensor-events` 뒤에 core로 보낼 모양이 그대로 찍혀요
   - 조도가 가려도 계속 `1023`이면 10kΩ 저항이 GND(− 줄)에 안 이어진 거예요. A0 선은 조도 센서와 저항이 만나는 줄에 꽂아요
5. 방 안 카메라(`ROOM_CAMERA`)를 같이 켜면 우노는 따로 보내지 않고 `재실 1번 방 PIR: 있음, 조도: 512 (카메라 이벤트에 합쳐 보냄)`이 떠요. 조도는 카메라 재실 이벤트의 `sources.light`로 같이 가요 (core는 기록만, 재실 판단엔 안 써요). 우노 값이 30초 넘게 안 오면 빼요

### ESP32 방 장치 (메인, 지금은 2번 방)

실제로 쓸 장치는 ESP32예요. 방마다 하나씩 달고, 젯슨 없이 와이파이로 core에 바로 보내요. 지금은 우노+젯슨이 1번 방, ESP32가 2번 방이에요 (`config.h`의 `ROOM_ID`).

**배선** ([docs/wiring-esp32.png](docs/wiring-esp32.png))

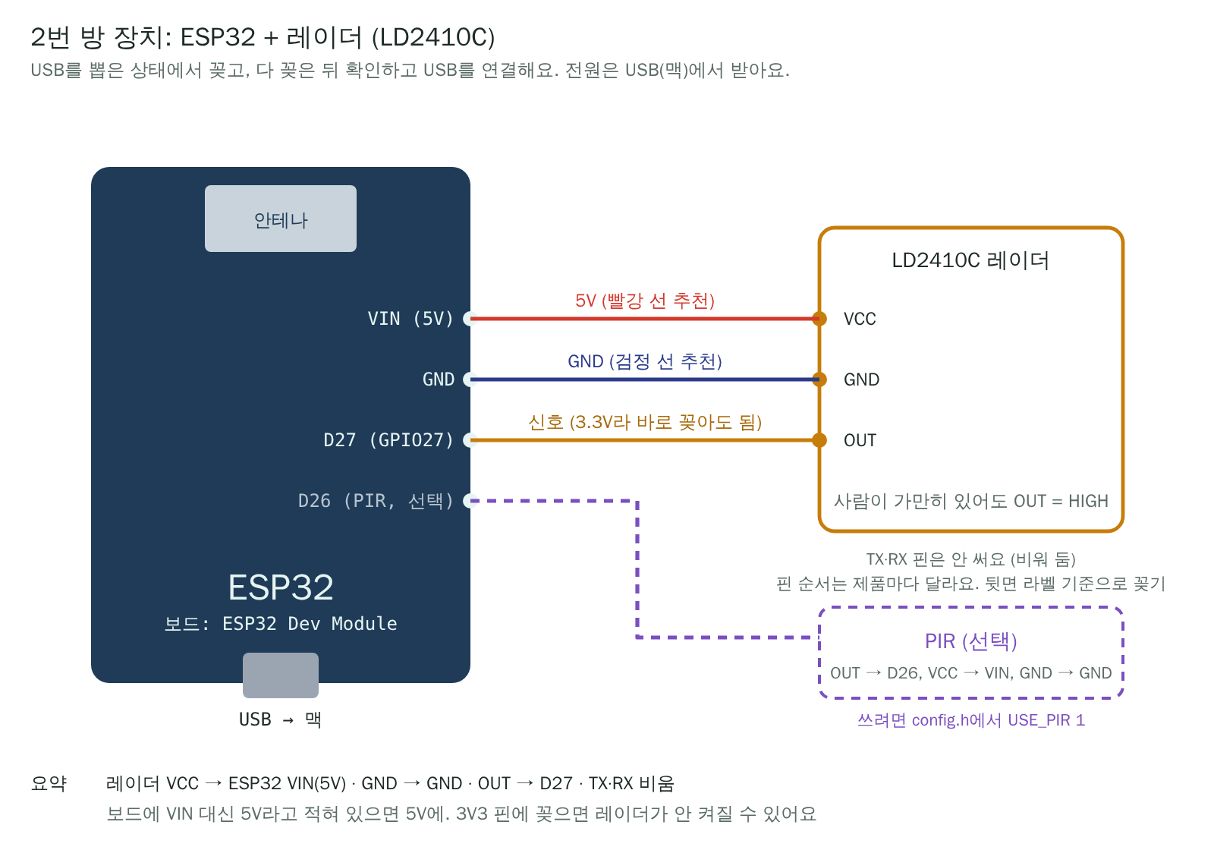
[picture p3: docs/wiring-esp32.png]
ESP32 배선도


| LD2410C 레이더 | ESP32 |
|---|---|
| VCC | VIN (5V) |
| GND | GND |
| OUT | D27 |
| TX · RX | 비움 |

**올리기**
1. 아두이노 IDE → 보드 매니저 → **esp32** (Espressif) 설치, 보드는 `ESP32 Dev Module`
2. `firmware/esp32_room_node/esp32_room_node.ino` 열기 (같은 폴더 파일이 탭으로 같이 열려요) → 업로드
3. 시리얼 모니터(115200): 레이더 앞에 서면 `재실 2번 방: 있음 (레이더=1)`, 그대로여도 10초마다 한 줄 + `[DRY_RUN] POST ...`

**와이파이·서버 (준비되면)**
1. `secrets.h.example`을 `secrets.h`로 복사해서 와이파이(2.4GHz), 서버 주소, 장치 토큰, 인증서 넣기. **GitHub에 안 올라가요**
2. `config.h`에서 `DRY_RUN 0`
3. 안전장치: 토큰이나 https 인증서가 없으면 보내지 않아요. 원격 `http://`도 막아요(맥 로컬 시험만 `ALLOW_HTTP_FOR_LOCAL_TEST 1`, 이때도 사설 주소 192.168.x.x·10.x·172.16~31.x나 `.local`만 허용)

**파일 (역할별)**

| 파일 | 하는 일 |
|---|---|
| `config.h` | 방 번호, 핀, 어떤 센서를 달았나(`USE_RADAR`, `USE_PIR`), 주기, DRY_RUN |
| `secrets.h` | 와이파이·서버 주소·토큰 (복사해서 만듦) |
| `occupancy.*` | 레이더·PIR 읽기 → "하나라도 있음이면 있음"으로 합치기, 바뀜/10초 판단 |
| `events.*` | core 형식 이벤트 (새 UUID eventId, 센서가 본 시각 observedAt) |
| `net.*` | 와이파이 연결·자동 재연결, 인터넷 시계 |
| `server.*` | 서버 설정 확인(토큰, https 인증서, 원격 http 막기) + POST 한 번 |
| `sender.*` | 큐에 모아 순서대로 전송. 5xx·연결 실패·401·403·404·408·429·리디렉션은 큐를 그대로 두고 같은 eventId로 재시도(1→2→4…30초). 400·409·413·422(이 이벤트 형식 문제)만 버림. 시계(NTP)를 기다리는 동안 1분마다 로그 |

큐는 32개(10초 신호 기준 약 5분)까지 모아요. 와이파이가 5분 넘게 끊기면 그 사이 기록은 오래된 것부터 일부 빠져요(정확도 측정 #13 때 참고). core는 다시 받은 시각부터 10·15분을 새로 재요.

**ESP32 확장 (나중에 붙일 자리)**

| 기능 | 할 일 |
|---|---|
| PIR 같이 달기 (정확도 비교, 이슈 #13) | `USE_PIR 1`, OUT → D26. 코드는 이미 있음 |
| CO2 (FR-DEV-104) | SCD40 읽는 파일 추가 → 1분마다 `makeCo2Event()`로 큐에 넣기. 보내는 쪽은 그대로 |
| 방 늘리기 | 같은 코드에 `ROOM_ID`·`DEVICE_ID`·토큰만 바꿔서 올리기 |

### 게이트웨이 구조

역할별로 나눠서, 하나를 바꿔도 나머지는 그대로예요.

| 부품 | 하는 일 |
|---|---|
| `Config`, `load_config()` | 설정값(서버 주소, DRY_RUN, 토큰, 포트)을 한곳에 모음 |
| `find_port()` | 우노가 꽂힌 USB 포트 찾기 |
| `DryRunVerifier` / `HttpVerifier` | 번호 확인기 (QR이 씀). 같은 `verify(body)` 모양이라 연습용·진짜 서버를 바꿔 끼움 |
| `handle_line()` + `HANDLERS` | 한 줄을 받아 `sensorType`별 처리기로 보냄 (`occupancy`. 옛 `keypad` 줄은 건너뜀) |
| `handle_occupancy()` | 우노 재실 줄을 core 형식(`kind: OCCUPANCY`, `occupied`, `sources`, `observedAt`)으로 바꿈 |
| `main()` | 위 부품을 조립하고 시리얼을 계속 읽음 |
| `qr_door.py` | 문 앞 웹캠 QR 입실 (`QR_CAMERA`). `QrDoor`가 QR 글자 → 같은 확인기 → OK/NO, `run_camera()`가 카메라에서 QR을 찾음 |
| `room_camera.py` | 방 안 웹캠 (`ROOM_CAMERA`). `RoomWatcher`가 사람 수 → 재실 이벤트, 빈 방이 되면 정리 확인. `YoloDetector`(모델 있을 때) / `HogPersonDetector`(없을 때) |
| `room_env.py` | 교육장 MQTT 센서 (`MQTT_ROOM`). `RoomEnv`가 업링크 → 중복·미래 시각 정리 → 기기별 최근 값 평균 → 1분마다 CO2 이벤트, `RoomRouter`는 방 여러 개(`MQTT_ROOMS`), `make_client()`는 구독만 하는 paho 클라이언트 |
| `fake_env_sensors.py` | 가짜 교육장 센서. 젯슨 안 브로커(localhost)에만 방마다 CO2·온도·습도 업링크를 1분마다 올림 (CO2 상한 950) |
| `sensor_adapters.py` | 센서 어댑터의 공통 모양. 센서마다 다른 입력(우노 시리얼·MQTT·카메라)을 core 이벤트 한 모양(`OccupancyEvent`·`Co2Event`)으로 바꿔 `push` 한 곳으로 보냄. `ADAPTERS` 표에 지금 있는 어댑터 3개, `check_event()`로 모양 확인. 새 센서는 어댑터 하나 + 표 한 줄 |
| `tidy_eval.py` | 정리 확인 채점. `capture`로 시험 사진 쌍과 정답을 모으고, `score`로 지금 설정의 정확도·심각한 오류·시간을 재고, `compare`로 여러 후보를 한 표로 비교 |

### 테스트

```bash
pip3 install -r gateway/requirements-dev.txt
pytest --cov --cov-report=term-missing   # 우노·서버 없이 가짜 시리얼로 게이트웨이를 확인해요
```

### CI (PR마다 자동)

| 확인 | 내용 | 합치기 조건 |
|---|---|---|
| `test` | 게이트웨이 테스트 + 커버리지 | develop · main 모두 통과해야 함 |
| `firmware` | 우노 펌웨어 컴파일 | develop · main 모두 통과해야 함 |
| `sonar` | 학교 SonarQube 서버 분석 (Secrets: `SONAR_HOST_URL`, `SONAR_TOKEN`) | develop은 결과 표시만, **main은 새 코드 커버리지 80% 이상** (품질 게이트) |
| CodeRabbit | AI 리뷰 (한국어) | 참고용. 팀원 1명 승인은 따로 필요 |

## 6. 이벤트 형식과 eventId

```json
{"eventId":"1-48213-19","roomId":1,"sensorType":"occupancy","pir":1,"light":512,"ms":13000}
```

- `eventId` = 방 번호 - 부팅 횟수 - 순서
- 중계가 같은 이벤트를 다시 보내도 서버가 같은 eventId는 **한 번만 저장**해요 (중복 제거)
- 가운데 부팅 횟수는 우노 EEPROM(전원을 꺼도 남는 메모리)에 저장돼서, 우노를 껐다 켜서 순서가 0부터 다시 시작해도 번호가 겹치지 않게 해요. 새 보드는 랜덤한 큰 수에서 시작해서 보드를 바꿔도 예전 번호와 겹치지 않아요
- 서버에는 이 값을 **UUID로 바꿔서** 보내요 (uuid5). 같은 입력이면 항상 같은 UUID라서 재전송해도 중복 제거가 그대로 돼요

## 7. 서버와 맞출 것 (core 지영님, 토큰 재웅님)

> 자세한 형식과 확인할 것 목록은 [docs/access-api.md](docs/access-api.md)에 있어요.

**출입 확인 (지영님 형식에 맞춤)**

```json
요청: {"eventId": "uuid", "roomId": 1, "deviceId": "qr-1", "code": "123456"}
응답: {"result": "OPENED"}  또는  {"result": "DENIED", "reason": "WRONG_CODE"}
```

중계는 `OPENED`일 때만 초록 LED, 그 밖에는(서버 응답 없음 포함) 빨간 LED를 켜요. 거부 이유는 로그에 남겨요.

| 아직 정할 것 | 내용 |
|---|---|
| `POST /api/access/verify` | 장치 토큰 발급, 개발 서버 HTTPS 주소 (재웅) |
| `POST /api/sensor-events` | 형식 초안 [docs/sensor-events-api.md](docs/sensor-events-api.md). core에 둘지, 응답·끊김 기준 (지영), 센서 장치 토큰 (재웅) |

## 8. 확장 계획

지금 구조는 **장비만 붙이면 동작하게** 만들어 뒀어요. 같은 이벤트 형식과 같은 API를 쓰기 때문이에요.

| 확장 | 붙일 것 | 바뀌는 곳 |
|---|---|---|
| 환기 알림 (FR-DEV-104) | CO2 센서 (SCD40) | 장치 코드에 센서 읽기만 추가 |
| 실제 도어락 · QR | 릴레이 + 잠금장치, QR 리더 | 같은 `/api/access/verify`를 부르는 장치만 교체 |
| 방마다 설치 | ESP32 + 센서 세트 | 방 번호(`ROOM_ID`)만 바꿔서 복제 |
| 환기 예측 | 젯슨 | CO2 기록으로 "곧 환기 필요" 미리 알림 (팀 결정 대기, Q-10) |
| 실제 에어컨·공기청정기 (FR-DEV-106) | LG·삼성 등 기기 어댑터 | 기기 파사드 뒤에 어댑터 하나 추가. core 명령은 그대로 |
| 실제 방 센서 | 방마다 CO2·온도·습도 센서 | 센서 어댑터 하나 + `ADAPTERS` 표 한 줄 (`sensor_adapters.py`) |
| 시나리오 시뮬레이션 (FR-DEV-107) | 가짜 센서 | 가짜 CO2를 카메라 인원에 맞춰 "입실 → CO2 상승 → 기기 자동 켜짐"을 보여 줌 |
| CO2 이상치 탐지 (FR-DEV-101) | 지금 수집하는 CO2 기록 | 장치에서 튀는 값을 골라 표시 |

## 9. 실험 기록 (품질 개선)

후보(모델·설정)를 채점할 때마다 여기에 남겨요. **최신이 맨 위**예요. 채택하지 않은 후보도 지우지 않아요. 같은 문제집끼리만 비교하고, 문제집을 바꾸면 기준선부터 다시 재요.

- **목표 (합격선):** 정확도 (깨끗함/남음) 95% 이상 · 심각한 오류 0 · 사진당 2분 안 (젯슨). 정리 확인은 퇴실 뒤 한 번만 보니까 1~2분까지 괜찮고 시간보다 정확도가 우선이에요 (11/11 수연, 처음엔 1초 → 10초 → 2분). 시연 때는 정확도가 비슷하면 빠른 후보를 써요
- **심각한 오류**는 둘로 나눠 봐요. **잘못 신고** = 깨끗한데 치울 것·두고 감으로 봄 (죄 없는 팀이 신고됨) / **놓침** = 치울 것·두고 감인데 깨끗함으로 봄 (다음 팀이 피해)
- **판단:** 합격선을 넘은 것 중 가장 좋은 것이 `채택`이에요. 아무도 못 넘으면 가장 나은 것을 `채택 (기준 미달: …)`으로 두고 다음 개선의 출발점으로 써요
- 순서: 합격선 넘음 → 정확도 (깨끗함/남음) 높은 순 → 심각 오류 적은 순 → 세 가지 정확도 높은 순 → 빠른 순. 11/10~11 1~4판은 세 가지 정확도로 매긴 기록이에요
- 기록 방법: 젯슨에서 `tidy_eval.py compare <문제집 폴더>` → 후보마다 "판별 기록"에 한 줄, 나온 `compare_*.md`는 "비교표 원본" 맨 위에 붙여요

### 문제집

| 이름 | 찍은 날 | 문제 수 | 내용 |
|---|---|---|---|
| `AI-go-do` (젯슨 `~/AI-go-do`) | 2026-11-10 | 47쌍 | 깨끗함 16 (조명 켬·끔, 의자·리모컨·블라인드·문, 앞 팀 물건 그대로·치움, 자리만 옮김, 방 리모컨을 책상에 둠) · 치울 것 14 (컵·피크닉·비닐·약 곽·휴지·영수증·티백·알약 포장, 바닥·의자 위 포함) · 두고 감 17 (텀블러·노트북·폰·가방·우산·아이패드·지갑·이어폰·충전기·종이·틴트, 바닥 작은 물건 포함) |

- 11/11 정답지 고침: 039(방 리모컨을 책상에 둠)를 두고 감 → 깨끗함으로 (원래 방 비품). 그 뒤 판은 모두 `ROOM_ITEMS=remote:1`로 채점. 1판은 그때 코드로 다시 잴 수 없어 고치기 전 결과로 그대로 둬요 (039 하나라 많아야 1문제 차이)
- 한계: 47쌍 모두 TV 있는 방 1곳, 낮에 찍음 (불 끈 쌍도 창문 빛 + 웹캠 자동 밝기로 차이가 작음). 밤 환경과 TV 없는 방은 나중에 추가
- 045(에어팟 케이스, 의자 아래)는 카메라에서 거의 안 보이는 사각이에요. 빼지 않고 그대로 둬요

### 채점이 맞는지 확인할 것

| 확인할 것 | 누가 어떻게 |
|---|---|
| ① 정답지가 맞나 (쌍마다 정답 1·2·3) | 수연이 47쌍 사진을 다시 보고 ✓/✗. ✗면 `answers.csv`를 고치고 지난 판도 다시 채점 |
| ② 채점기가 정답지대로 매기나 | 가짜 결과를 넣어 보는 시험 21개 (`gateway/tests/test_tidy_eval.py`) |
| ③ 틀린 문제가 진짜 틀린 건가 | 판마다 틀린 문제 사진을 직접 보고 "모델 탓 / 사진 탓(사람·흔들림) / 정답지 탓"으로 적기 |

### 판별 기록 (최신이 맨 위)

판 하나 = 같은 문제집으로 후보 하나를 채점한 것. 판마다 **한 가지만** 바꾸고, 무엇을 바꿨고 왜 점수가 변했는지 적어요.

1~4판은 세 가지 정확도로 순위를 매겼어요. 그 판의 "깨끗함/남음" 칸은 같은 설정을 5판에서 다시 잰 값이고, 다시 재지 않은 것은 `-`예요.

| 판 | 판단 | 정확도 (깨끗함/남음) | 세 가지 정확도 (깨끗함 / 치울 것 / 두고 감) | 심각 오류 (잘못 신고 / 놓침) | 사진당 시간 (최대) | 무엇을 바꿨고 왜 변했나 |
|---|---|---|---|---|---|---|
| 12판 · 11-13 09:53 · 지금 설정(화면 전체 비교, `DESK_MOVE=1`, VLM or) + 가구 이름 다시 확인 (`DESK_FURNITURE_SEEN=1`) | 채택 (기준 미달) | **89.4%** | - | 5 (4 / 1) | 11.72초 (-) | 놓침 1개 줄고 잘못 신고는 그대로. 고르는 규칙(수연, 결과 보기 전): 심각 오류 합계가 적은 쪽, 같으면 덜 바꾼 쪽, 1차로만. 2차(15쌍, 참고)는 60.0%, 6 (2 / 4)로 기준과 같음 |
| 12판 · 11-13 09:53 · 기준: 지금 설정 그대로 (`DESK_AREA=0,0,1,1 TILE_GRID=3 DESK_MOVE=1`, VLM or) | 비교용 | **87.2%** | - | 6 (4 / 2) | 11.70초 (-) | 방에 맞춘 설정을 뺀 뒤 기준. 같은 판에서 `exp/desk-rules`의 다른 규칙 2개(입실 물건 자리 새 물건, 같은 이름 새 자리)는 1차 변화 없어 안 씀. 2차(참고) 60.0%. VLM 4B(Qwen3-VL-4B)는 젯슨 B(7.3GB) 메모리 한도에서 두 번 꺼져 채점 못 함 |
| 11판 · 11-12 14:29 · 10판과 같은 설정을 develop(#65 합친 뒤)에서 다시 채점 | 확인용 | **87.2%** | 68.1% (81% / 86% / 41%) | 6 (3 / 3) | 33.78초 (-) | 10판 결과가 그대로 나오는지 확인. 깨끗함/남음은 같고 틀린 문제(004·009·013 잘못 신고, 019·035·037 놓침)도 같음. 세 가지 정확도만 조금 다름 (치울 것 ↔ 두고 감 종류 혼동 차이). 이번 기록부터 "물건이 있을 확률" 표에 쓰는 경우별 기록(다시 확인 포함)이 남음. VLM 답은 캐시에서 읽음 |
| 10판 · 11-12 10:16 · 9판 1등 + VLM Qwen3-VL-2B "하나라도 남음이면 남음" (`VLM_URL VLM_RULE=or`, 실험 브랜치) | 채택 (기준 미달) | **87.2%** | 66.0% (81% / 71% / 47%) | 6 (3 / 3) | 33.46초 (34.29초) | 지금까지 1등. 젯슨 CPU에서 llama.cpp로 VLM(사진을 보고 말로 답하는 AI)을 띄우고, 입실·퇴실 사진 두 장을 보여 주며 "새로 생긴 물건이 있나?"를 YES/NO로 물음. YOLO가 깨끗함이라 해도 VLM이 YES면 남음. 놓침 6 → 3 (030 등 멀거나 작은 물건 일부). 잘못 신고 3(004·009·013)은 YOLO 쪽이라 그대로. 사진당 30초 늘었지만 11/11 수연이 정한 1~2분 안. 모델 Apache-2.0, VLM 서버 메모리(약 2.3GB)는 표의 메모리에 안 들어감 |
| 10판 · 11-12 10:16 · Qwen VLM만 | 탈락 | **72.3%** | 46.8% (100% / 0% / 35%) | 13 (0 / 13) | 33.46초 (34.22초) | VLM 혼자. **깨끗한 방 잘못 신고 0** (YOLO가 틀린 004·009·013도 VLM은 맞힘). 대신 놓침 13: 조심스러워서 작은 컵·종이는 "없다"고 봄 |
| 10판 · 11-12 10:16 · Qwen 둘 다 남음일 때만 남음 | 탈락 | **66.0%** | 57.4% (100% / 64% / 12%) | 16 (0 / 16) | 33.61초 (34.74초) | 잘못 신고는 0이 되지만 VLM 놓침이 그대로 더해져 손해 |
| 10판 · 11-12 09:37 · SmolVLM-500M 하나라도 남음이면 | 탈락 | **80.9%** | 63.8% (81% / 71% / 41%) | 9 (3 / 6) | 18.02초 (19.70초) | 9판 1등과 똑같음. SmolVLM은 47쌍 모두 "없다(NO)"로 답해서 아무것도 안 바뀜. 5억 크기 모델은 두 사진 비교를 못 하는 것으로 **추정** |
| 10판 · 11-12 09:37 · SmolVLM 둘 다 / VLM만 | 탈락 | **34.0%** | 34.0% (100% / 0% / 0%) | 31 (0 / 31) | 18.04초 (26.26초) | 모두 깨끗함으로 답해서 남은 방 31개를 다 놓침 |
| 9판 · 11-11 21:29 · SSIM 25 + 옮김 빼기 기준 1.0 (`DESK_MOVE=1 DESK_MOVE_SAME=1.0`, 실험 브랜치) | 채택 (기준 미달) | **80.9%** | 63.8% (81% / 71% / 41%) | 9 (3 / 6) | 2.92초 (3.44초) | 지금까지 1등. 바뀐 자리의 물건 무늬(테두리)가 입실 사진에도 퇴실만큼 있어야 "원래 있던 물건을 옮김"으로 보고 뺌. 8판(0.67)은 불이 꺼져 퇴실 사진 무늬가 줄면 새 컵도 빠졌는데, 1.0으로 엄격하게 하니 8판에서 새로 놓친 6개 중 5개(016·021·023·033·043)가 돌아옴. 리모컨만 옮긴 잘못 신고(005·006·007·010)는 그대로 없어짐 |
| 9판 · 11-11 21:29 · 옮김 빼기 기준 1.3 | 탈락 | **78.7%** | 59.6% (62% / 79% / 41%) | 10 (6 / 4) | 2.92초 (5.74초) | 더 엄격하게. 놓침은 줄지만 리모컨 옮김(005·007·010)을 다시 새 물건으로 봐서 잘못 신고 3 → 6 |
| 9판 · 11-11 21:29 · 잘라서 비교 0.9 (`DESK_MATCH=1 DESK_MATCH_SIM=0.9`, 실험 브랜치) | 탈락 | **74.5%** | 59.6% (69% / 71% / 41%) | 12 (5 / 7) | 4.68초 (18.46초) | 수연 아이디어: 늘어난 물건을 잘라 입실 사진의 물건 조각과 DINOv2로 비교해, 같은 물건이면 안 셈. SSIM 25보다 낮음. 작은 조각만으로는 같은 물건을 잘 못 알아보고, 불이 꺼지면 같은 물건도 달라 보이는 것으로 **추정**. 메모리 626MB, 최대 18초 |
| 9판 · 11-11 21:29 · 잘라서 비교 0.8 | 탈락 | **72.3%** | 57.4% (69% / 64% / 41%) | 13 (5 / 8) | 4.71초 (18.27초) | 같은 물건 기준을 느슨하게 하니 새 물건도 같은 것으로 봐서 놓침 +1 |
| 8판 · 11-11 18:08 · v8s + SSIM 기준 25 | 채택 (기준 미달) | **76.6%** | 57.4% (56% / 79% / 41%) | 11 (7 / 4) | 2.95초 (5.81초) | 같은 설정을 네 번째 다시 잼. 점수가 같아 채점이 매번 같게 나와요 |
| 8판 · 11-11 18:08 · SSIM 25 + 옮김 빼기 (`DESK_MOVE=1`, 기준 0.67, 실험 브랜치) | 탈락 | **74.5%** | 59.6% (100% / 50% / 29%) | 12 (0 / 12) | 2.73초 (3.20초) | 원래 있던 물건(리모컨)을 옮기거나 뒤집은 자리는 새 물건으로 안 셈 (자리의 무늬가 입실 사진에도 비슷하게 있으면 "원래 있던 것"). **깨끗한 방 잘못 신고 7 → 0.** 대신 기준이 느슨해서 불이 꺼져 퇴실 사진 무늬가 줄면 새 컵·폰까지 빠져 놓침 4 → 12 (016·021·022·023·033·043 등). 9판에서 기준을 1.0으로 고침 |
| 8판 · 11-11 18:08 · + 작은 것도 (`DESK_MIN_AREA=0.0005`) | 탈락 | **74.5%** | 59.6% (100% / 50% / 29%) | 12 (0 / 12) | 2.70초 (3.21초) | 효과 0. 놓친 건 크기 때문이 아니라 옮김 빼기 때문 |
| 8판 · 11-11 18:08 · SSIM 20 + 옮김 빼기 | 탈락 | **74.5%** | 57.4% (88% / 57% / 29%) | 12 (2 / 10) | 2.71초 (3.28초) | 더 예민하게. 놓침 2개를 찾지만 잘못 신고 2개가 생겨 같음 |
| 7판 · 11-11 16:52 · v8s + SSIM 기준 25 | 채택 (기준 미달) | **76.6%** | 57.4% (56% / 79% / 41%) | 11 (7 / 4) | 3.01초 (6.04초) | 같은 설정을 세 번째 다시 잼. 점수가 같아 채점이 매번 같게 나와요 |
| 7판 · 11-11 16:52 · DINOv2 특징 비교 기준 60 (`DESK_LIGHT=dino`, 실험 브랜치) | 탈락 | **68.1%** | 48.9% (19% / 93% / 41%) | 15 (13 / 2) | 6.25초 (9.07초) | 책상 비교를 픽셀 무늬 대신 DINOv2-small 특징(14×14칸마다 "무엇이 있나")의 차이로 바꿈 (ICRA 2025·CVPR 2025 GeSCF와 같은 방향). 놓침 4 → 2로 줄었지만 깨끗한 방 잘못 신고 7 → 13으로 늘어 손해. 메모리 339 → 623MB, 시간 2배 |
| 7판 · 11-11 16:52 · DINOv2 기준 120 | 탈락 | **68.1%** | 46.8% (19% / 86% / 41%) | 15 (13 / 2) | 4.73초 (6.91초) | 덜 예민하게 해도 잘못 신고 13 그대로. 기준값 조절로는 안 풀림 |
| 7판 · 11-11 16:52 · DINOv2 기준 90 | 탈락 | **66.0%** | 42.6% (6% / 86% / 41%) | 16 (15 / 1) | 5.57초 (8.43초) | 놓침 1로 가장 적지만 잘못 신고 15. 불 켬↔끔 같은 변화도 "다른 장면"으로 보는 것으로 **추정** (사례별 확인 전) |
| 6판 · 11-11 16:14 · v8s + SSIM 기준 25 | 채택 (기준 미달) | **76.6%** | 57.4% (56% / 79% / 41%) | 11 (7 / 4) | 3.01초 (6.43초) | 5판 1등을 그대로 다시 잼. 점수가 같아 채점이 매번 같게 나와요 |
| 6판 · 11-11 16:14 · + 치운 자리 빼기 (`DESK_GONE=1`, 실험 브랜치) | 탈락 | **76.6%** | 57.4% (56% / 79% / 41%) | 11 (7 / 4) | 3.02초 (5.84초) | 바뀐 자리의 무늬가 기준 사진 쪽에 더 많으면 "치움"으로 보고 뺌 (두고 간/치운 물건 구분, 감시 카메라 연구의 방법). 효과 0: 컵·가방을 치운 010·013은 그대로. 이유는 사진 확인 전 |
| 6판 · 11-11 16:14 · + 밝기 맞추기 (`DESK_EQ=1`, 실험 브랜치) | 탈락 | **70.2%** | 51.1% (38% / 79% / 41%) | 14 (10 / 4) | 3.05초 (5.80초) | 지금 사진 밝기·대비를 기준에 맞춘 뒤 비교. 깨끗한 방 잘못 신고 7 → 10으로 역효과. 잡음까지 키운 것으로 **추정** |
| 6판 · 11-11 16:14 · + 둘 다 | 탈락 | **70.2%** | 51.1% (38% / 79% / 41%) | 14 (10 / 4) | 3.05초 (5.99초) | 밝기 맞추기와 같음 |
| 5판 · 11-11 15:39 · v8s + SSIM 기준 25 | 채택 (기준 미달) | **76.6%** | 57.4% (56% / 79% / 41%) | 11 (7 / 4) | 3.13초 (5.86초) | 코드는 4판과 같고 **채점 방식만** 바꿈 (#53). 사용자에게는 쓰레기와 두고 간 물건을 구별하지 않고 알리고 core도 `CLEAN / LEFT_ITEMS` 두 가지로만 받아서, 깨끗함/남음만 맞으면 정답으로 셈. 4판에서 틀린 20문제 중 9문제가 쓰레기 ↔ 두고 감만 바뀐 것(대부분 이름 못 붙인 `unknown`을 치울 것으로 봄)이라 +19.2%p. 세 가지 정확도·심각 오류는 4판과 똑같아 채점이 매번 같게 나와요. 시간은 합격선(10초) 안. 남은 심각 오류 11: 치운 물건을 새 물건으로 봄 2(010·013), 불 켬↔끔 4(004·009·026·030), 리모컨만 만졌는데 laptop 2(006·007), 기타 3 (사례별 확인 전 **추정**) |
| 5판 · 11-11 15:39 · v8s + SSIM 기준 50 | 탈락 | **76.6%** | 53.2% (50% / 71% / 41%) | 11 (8 / 3) | 3.21초 (5.82초) | 깨끗함/남음·심각 오류는 1등과 같고, 세 가지 정확도에서 밀림 |
| 5판 · 11-11 15:39 · v8s + SSIM 기준 35 | 탈락 | **72.3%** | 46.8% (44% / 64% / 35%) | 13 (9 / 4) | 3.14초 (5.87초) | 4판과 같음 |
| 5판 · 11-11 15:39 · 기준 밝기 자리마다 | 비교용 | **68.1%** | 48.9% (31% / 79% / 41%) | 15 (11 / 4) | 3.21초 (5.29초) | 3판 기준선을 새 채점으로. SSIM 25가 +8.5%p |
| 4판 · 11-11 14:21 · v8s + SSIM 기준 25 | 채택 (기준 미달) | 76.6% | 57.4% (56% / 79% / 41%) | 11 (7 / 4) | 3.00초 (5.79초) | 책상 비교를 밝기 차이 대신 SSIM(무늬가 달라졌나)으로 바꿈 (실험 브랜치 `exp/desk-ssim`, 아직 develop에 없음). 깨끗한 방 잘못 신고 11 → 7, 정확도 +8.5%p, 놓침은 그대로. 빛·그림자 변화로 생긴 잘못 신고 일부가 사라진 것으로 **추정** (사례별 확인 전). 두고 감 41%는 그대로라 다음 과제 |
| 4판 · 11-11 14:21 · v8s + SSIM 기준 50 | 탈락 | 76.6% | 53.2% (50% / 71% / 41%) | 11 (8 / 3) | 3.13초 (5.63초) | 덜 예민하게. 놓침은 1 줄지만 치울 것을 1개 더 놓쳐요 |
| 4판 · 11-11 14:21 · v8s + SSIM 기준 35 | 탈락 | 72.3% | 46.8% (44% / 64% / 35%) | 13 (9 / 4) | 3.04초 (6.07초) | SSIM 기본값. 25·50보다 나빠 기준값에 따라 결과가 들쭉날쭉해요 (문제 수가 적어 1~2문제 차이가 크게 보임) |
| 4판 · 11-11 14:21 · 기준 밝기 자리마다 | 비교용 | 68.1% | 48.9% (31% / 79% / 41%) | 15 (11 / 4) | 3.29초 (5.41초) | 3판 기준선을 같은 날 다시 잼. 점수가 똑같아 채점이 매번 같게 나와요 |
| 3판 · 11-11 13:55 · 기준 v8s | 채택 (기준 미달) | 68.1% | 48.9% (31% / 79% / 41%) | 15 (11 / 4) | 3.13초 (5.12초) | 3판 기준선. 모두 `DESK_LIGHT=local ROOM_ITEMS=remote:1` 위에서 모델만 바꿈. 2판과 똑같이 나와 채점이 매번 같게 나와요. 어떤 모델이든 잘못 신고가 10~12건이라, 잘못 신고는 모델보다 책상 사진 비교에서 나오는 것으로 **추정** (틀린 문제 사진은 아직 하나씩 확인 전) |
| 3판 · 11-11 13:55 · yolo11s | 탈락 | - | 46.8% (38% / 64% / 41%) | 15 (10 / 5) | 2.74초 (4.80초) | 2024년 새 버전. 깨끗한 방은 1개 더 맞지만 치울 것을 2개 더 놓쳐요 |
| 3판 · 11-11 13:55 · yolo11s + YOLO-World 이름 | 탈락 | - | 40.4% (31% / 57% / 35%) | 15 (11 / 4) | 2.90초 (5.58초) | 이름 붙이기 모델을 더하니 치울 것·두고 감이 함께 떨어져요 |
| 3판 · 11-11 13:55 · v8s + YOLO-World 이름 | 탈락 | - | 40.4% (25% / 57% / 41%) | 16 (12 / 4) | 3.33초 (5.46초) | 달라진 곳에 우리 물건 22가지 이름을 붙임. 치울 것 79% → 57%로 오히려 손해 (컵·종이에 다른 이름을 붙여 빼거나 잘못 나눔으로 추정) |
| 3판 · 11-11 13:55 · yolov8m (참고) | 탈락 | - | 40.4% (31% / 57% / 35%) | 16 (11 / 5) | 7.96초 (13.99초) | v8s보다 2.5배 큰 모델. 더 느리고 낫지 않아요 |
| 2판 · 11-11 10:07 · v8s + 책상 + 밝기 자리마다 (재채점) | 2등, 다음 판 기준으로 씀 | - | 48.9% (31% / 79% / 41%) | 15 (11 / 4) | 3.20초 | 039 정답지를 고치고 `ROOM_ITEMS=remote:1`로 다시 잼. 순서 규칙대로면 1등은 "기준 50"(`DESK_THRESH=50`, 51.1%, 1문제 더 맞음)이에요. 하지만 놓침이 4 → 9로 늘어 심각 오류가 15 → 20이라, 다음 판(3·4판)의 출발점은 심각 오류가 가장 적은 이것으로 정함 (11/11 수연). 바닥 확대(`FLOOR_AREA=0.05,0.6,0.8,0.85`)는 효과 0, 시간만 +1.4초 |
| 2판 · 11-11 09:48 · 설정 6개 (정답지 고치기 전) | 참고 | - | 1등 "밝기 자리마다, 기준 50" 51.1% (27 / 79 / 50) | 20 (11 / 9) | 3.03초 | 의자 빼기(#47)·밝기 자리마다(#48)는 조금 효과. 기준 50은 놓침 증가, 작은 것 무시(`DESK_MIN_AREA=0.004`)는 46.8%로 역효과, 바닥 확대는 위치가 틀려 효과 0. 깨끗한 방 잘못 신고 11건은 설정으로 안 줄어 책상 비교 방식 자체를 바꿔야 함 |
| 1판 · 11-10 17:50 · v8s + 책상 (정답지 고치기 전) | 채택 (기준 미달) | - | 46.8% (13% / 79% / 50%) | 18 (13 / 5) | 2.97초 (4.89초) | 기준선. 책상 사진 비교를 켜면 치울 것·두고 감을 더 잡지만(놓침 29 → 5), 깨끗한 15쌍 중 13쌍을 잘못 신고해요. 불 켬→끔·블라인드·문 빛처럼 밝기가 바뀌거나 의자·리모컨이 움직인 것을 "새 물건"으로 보는 것으로 추정 (틀린 문제 확인 전) |
| 1판 · 11-10 17:50 · v8s (지금, 정답지 고치기 전) | 탈락 | - | 36.2% (93% / 0% / 17%) | 30 (1 / 29) | 1.33초 (1.55초) | 기준선. 깨끗한 방은 잘 맞히지만 쓰레기는 하나도 못 잡고 두고 간 물건도 거의 놓쳐요. 80종 모델이 위에서 본 작은 컵·종이·영수증 등을 모르기 때문으로 추정 |

### 비교표 원본 (최신이 맨 위)

`compare`가 만든 `compare_*.md`를 그대로 붙여요.

#### 2026-11-12 10:16 · 정리 확인 후보 비교 (문제 47개, 후보 3개)

**채택:** qwen 하나라도 남음이면 · 정확도 (깨끗함/남음) 87.2% · 세 가지 66.0% · 심각 오류 6 · 사진당 33.46초 · 메모리 311MB

목표: 정확도 (깨끗함/남음) 95% 이상 · 심각 오류 0 · 사진당 10초 안

| 순위 | 판단 | 후보 | 정확도 (깨끗함/남음) | 세 가지 정확도 (깨끗함 / 치울 것 / 두고 감) | 심각 오류 (잘못 신고 / 놓침) | 사진당 시간 (최대) | 메모리 최대 | 모델 올리기 | 라이선스 |
|---|---|---|---|---|---|---|---|---|---|
| 1 | 채택 (기준 미달: 정확도, 심각 오류, 시간) | qwen 하나라도 남음이면 | **87.2%** | 66.0% (81% / 71% / 47%) | 6 (3 / 3) | 33.46초 (34.29초) | 311MB | 3.1초 | AGPL-3.0 (Ultralytics) |
| 2 | 탈락 (정확도, 심각 오류, 시간) | qwen VLM만 | **72.3%** | 46.8% (100% / 0% / 35%) | 13 (0 / 13) | 33.46초 (34.22초) | 322MB | 3.6초 | AGPL-3.0 (Ultralytics) |
| 3 | 탈락 (정확도, 심각 오류, 시간) | qwen 둘다 남음일때만 | **66.0%** | 57.4% (100% / 64% / 12%) | 16 (0 / 16) | 33.61초 (34.74초) | 312MB | 3.4초 | AGPL-3.0 (Ultralytics) |

#### 2026-11-12 09:37 · 정리 확인 후보 비교 (문제 47개, 후보 3개)

**채택:** smol 하나라도 남음이면 · 정확도 (깨끗함/남음) 80.9% · 세 가지 63.8% · 심각 오류 9 · 사진당 18.02초 · 메모리 313MB

목표: 정확도 (깨끗함/남음) 95% 이상 · 심각 오류 0 · 사진당 10초 안

| 순위 | 판단 | 후보 | 정확도 (깨끗함/남음) | 세 가지 정확도 (깨끗함 / 치울 것 / 두고 감) | 심각 오류 (잘못 신고 / 놓침) | 사진당 시간 (최대) | 메모리 최대 | 모델 올리기 | 라이선스 |
|---|---|---|---|---|---|---|---|---|---|
| 1 | 채택 (기준 미달: 정확도, 심각 오류, 시간) | smol 하나라도 남음이면 | **80.9%** | 63.8% (81% / 71% / 41%) | 9 (3 / 6) | 18.02초 (19.70초) | 313MB | 9.6초 | AGPL-3.0 (Ultralytics) |
| 2 | 탈락 (정확도, 심각 오류, 시간) | smol 둘다 남음일때만 | **34.0%** | 34.0% (100% / 0% / 0%) | 31 (0 / 31) | 18.04초 (26.26초) | 317MB | 3.0초 | AGPL-3.0 (Ultralytics) |
| 3 | 탈락 (정확도, 심각 오류, 시간) | smol VLM만 | **34.0%** | 34.0% (100% / 0% / 0%) | 31 (0 / 31) | 18.06초 (19.34초) | 311MB | 3.0초 | AGPL-3.0 (Ultralytics) |

#### 2026-11-11 21:29 · 정리 확인 후보 비교 (문제 47개, 후보 4개)

**채택:** 옮김 빼기 덜 세게 1.0 · 정확도 (깨끗함/남음) 80.9% · 세 가지 63.8% · 심각 오류 9 · 사진당 2.92초 · 메모리 338MB

목표: 정확도 (깨끗함/남음) 95% 이상 · 심각 오류 0 · 사진당 10초 안

| 순위 | 판단 | 후보 | 정확도 (깨끗함/남음) | 세 가지 정확도 (깨끗함 / 치울 것 / 두고 감) | 심각 오류 (잘못 신고 / 놓침) | 사진당 시간 (최대) | 메모리 최대 | 모델 올리기 | 라이선스 |
|---|---|---|---|---|---|---|---|---|---|
| 1 | 채택 (기준 미달: 정확도, 심각 오류) | 옮김 빼기 덜 세게 1.0 | **80.9%** | 63.8% (81% / 71% / 41%) | 9 (3 / 6) | 2.92초 (3.44초) | 338MB | 2.9초 | AGPL-3.0 (Ultralytics) |
| 2 | 탈락 (정확도, 심각 오류) | 옮김 빼기 덜 세게 1.3 | **78.7%** | 59.6% (62% / 79% / 41%) | 10 (6 / 4) | 2.92초 (5.74초) | 340MB | 2.9초 | AGPL-3.0 (Ultralytics) |
| 3 | 탈락 (정확도, 심각 오류) | 잘라서 비교 0.9 | **74.5%** | 59.6% (69% / 71% / 41%) | 12 (5 / 7) | 4.68초 (18.46초) | 626MB | 2.8초 | AGPL-3.0 (Ultralytics) |
| 4 | 탈락 (정확도, 심각 오류) | 잘라서 비교 0.8 | **72.3%** | 57.4% (69% / 64% / 41%) | 13 (5 / 8) | 4.71초 (18.27초) | 630MB | 2.9초 | AGPL-3.0 (Ultralytics) |

#### 2026-11-11 18:08 · 정리 확인 후보 비교 (문제 47개, 후보 4개)

**채택:** SSIM 기준 25 · 정확도 (깨끗함/남음) 76.6% · 세 가지 57.4% · 심각 오류 11 · 사진당 2.95초 · 메모리 338MB

목표: 정확도 (깨끗함/남음) 95% 이상 · 심각 오류 0 · 사진당 10초 안

| 순위 | 판단 | 후보 | 정확도 (깨끗함/남음) | 세 가지 정확도 (깨끗함 / 치울 것 / 두고 감) | 심각 오류 (잘못 신고 / 놓침) | 사진당 시간 (최대) | 메모리 최대 | 모델 올리기 | 라이선스 |
|---|---|---|---|---|---|---|---|---|---|
| 1 | 채택 (기준 미달: 정확도, 심각 오류) | SSIM 기준 25 | **76.6%** | 57.4% (56% / 79% / 41%) | 11 (7 / 4) | 2.95초 (5.81초) | 338MB | 2.9초 | AGPL-3.0 (Ultralytics) |
| 2 | 탈락 (정확도, 심각 오류) | SSIM 25 + 옮김 빼기 + 작은 것도 | **74.5%** | 59.6% (100% / 50% / 29%) | 12 (0 / 12) | 2.70초 (3.21초) | 337MB | 2.8초 | AGPL-3.0 (Ultralytics) |
| 3 | 탈락 (정확도, 심각 오류) | SSIM 25 + 옮김 빼기 | **74.5%** | 59.6% (100% / 50% / 29%) | 12 (0 / 12) | 2.73초 (3.20초) | 338MB | 3.2초 | AGPL-3.0 (Ultralytics) |
| 4 | 탈락 (정확도, 심각 오류) | SSIM 20 + 옮김 빼기 | **74.5%** | 57.4% (88% / 57% / 29%) | 12 (2 / 10) | 2.71초 (3.28초) | 338MB | 2.9초 | AGPL-3.0 (Ultralytics) |

#### 2026-11-11 16:52 · 정리 확인 후보 비교 (문제 47개, 후보 4개)

**채택:** SSIM 기준 25 · 정확도 (깨끗함/남음) 76.6% · 세 가지 57.4% · 심각 오류 11 · 사진당 3.01초 · 메모리 339MB

목표: 정확도 (깨끗함/남음) 95% 이상 · 심각 오류 0 · 사진당 10초 안

| 순위 | 판단 | 후보 | 정확도 (깨끗함/남음) | 세 가지 정확도 (깨끗함 / 치울 것 / 두고 감) | 심각 오류 (잘못 신고 / 놓침) | 사진당 시간 (최대) | 메모리 최대 | 모델 올리기 | 라이선스 |
|---|---|---|---|---|---|---|---|---|---|
| 1 | 채택 (기준 미달: 정확도, 심각 오류) | SSIM 기준 25 | **76.6%** | 57.4% (56% / 79% / 41%) | 11 (7 / 4) | 3.01초 (6.04초) | 339MB | 3.1초 | AGPL-3.0 (Ultralytics) |
| 2 | 탈락 (정확도, 심각 오류) | DINO 기준 60 | **68.1%** | 48.9% (19% / 93% / 41%) | 15 (13 / 2) | 6.25초 (9.07초) | 623MB | 4.2초 | AGPL-3.0 (Ultralytics) |
| 3 | 탈락 (정확도, 심각 오류) | DINO 기준 120 | **68.1%** | 46.8% (19% / 86% / 41%) | 15 (13 / 2) | 4.73초 (6.91초) | 628MB | 3.0초 | AGPL-3.0 (Ultralytics) |
| 4 | 탈락 (정확도, 심각 오류) | DINO 기준 90 | **66.0%** | 42.6% (6% / 86% / 41%) | 16 (15 / 1) | 5.57초 (8.43초) | 627MB | 3.0초 | AGPL-3.0 (Ultralytics) |

#### 2026-11-11 16:14 · 정리 확인 후보 비교 (문제 47개, 후보 4개)

**채택:** SSIM 25 (5판 1등) · 정확도 (깨끗함/남음) 76.6% · 세 가지 57.4% · 심각 오류 11 · 사진당 3.01초 · 메모리 339MB

목표: 정확도 (깨끗함/남음) 95% 이상 · 심각 오류 0 · 사진당 10초 안

| 순위 | 판단 | 후보 | 정확도 (깨끗함/남음) | 세 가지 정확도 (깨끗함 / 치울 것 / 두고 감) | 심각 오류 (잘못 신고 / 놓침) | 사진당 시간 (최대) | 메모리 최대 | 모델 올리기 | 라이선스 |
|---|---|---|---|---|---|---|---|---|---|
| 1 | 채택 (기준 미달: 정확도, 심각 오류) | SSIM 25 (5판 1등) | **76.6%** | 57.4% (56% / 79% / 41%) | 11 (7 / 4) | 3.01초 (6.43초) | 339MB | 3.0초 | AGPL-3.0 (Ultralytics) |
| 2 | 탈락 (정확도, 심각 오류) | + 치운 자리 빼기 | **76.6%** | 57.4% (56% / 79% / 41%) | 11 (7 / 4) | 3.02초 (5.84초) | 339MB | 2.9초 | AGPL-3.0 (Ultralytics) |
| 3 | 탈락 (정확도, 심각 오류) | + 밝기 맞추기 | **70.2%** | 51.1% (38% / 79% / 41%) | 14 (10 / 4) | 3.05초 (5.80초) | 339MB | 3.2초 | AGPL-3.0 (Ultralytics) |
| 4 | 탈락 (정확도, 심각 오류) | + 둘 다 | **70.2%** | 51.1% (38% / 79% / 41%) | 14 (10 / 4) | 3.05초 (5.99초) | 339MB | 2.9초 | AGPL-3.0 (Ultralytics) |

#### 2026-11-11 15:39 · 정리 확인 후보 비교 (문제 47개, 후보 4개)

**채택:** SSIM 기준 25 (더 예민) · 정확도 (깨끗함/남음) 76.6% · 세 가지 57.4% · 심각 오류 11 · 사진당 3.13초 · 메모리 339MB

목표: 정확도 (깨끗함/남음) 95% 이상 · 심각 오류 0 · 사진당 10초 안

| 순위 | 판단 | 후보 | 정확도 (깨끗함/남음) | 세 가지 정확도 (깨끗함 / 치울 것 / 두고 감) | 심각 오류 (잘못 신고 / 놓침) | 사진당 시간 (최대) | 메모리 최대 | 모델 올리기 | 라이선스 |
|---|---|---|---|---|---|---|---|---|---|
| 1 | 채택 (기준 미달: 정확도, 심각 오류) | SSIM 기준 25 (더 예민) | **76.6%** | 57.4% (56% / 79% / 41%) | 11 (7 / 4) | 3.13초 (5.86초) | 339MB | 2.9초 | AGPL-3.0 (Ultralytics) |
| 2 | 탈락 (정확도, 심각 오류) | SSIM 기준 50 (덜 예민) | **76.6%** | 53.2% (50% / 71% / 41%) | 11 (8 / 3) | 3.21초 (5.82초) | 339MB | 2.9초 | AGPL-3.0 (Ultralytics) |
| 3 | 탈락 (정확도, 심각 오류) | SSIM 기준 35 | **72.3%** | 46.8% (44% / 64% / 35%) | 13 (9 / 4) | 3.14초 (5.87초) | 339MB | 2.9초 | AGPL-3.0 (Ultralytics) |
| 4 | 탈락 (정확도, 심각 오류) | 기준 밝기 자리마다 | **68.1%** | 48.9% (31% / 79% / 41%) | 15 (11 / 4) | 3.21초 (5.29초) | 335MB | 3.5초 | AGPL-3.0 (Ultralytics) |

#### 2026-11-11 14:21 · 정리 확인 후보 비교 (문제 47개, 후보 4개)

**채택:** SSIM 기준 25 (더 예민) · 정확도 57.4% · 심각 오류 11 · 사진당 3.00초 · 메모리 341MB

목표: 정확도 95% 이상 · 심각 오류 0 · 사진당 1초 안

| 순위 | 판단 | 후보 | 정확도 (깨끗함 / 치울 것 / 두고 감) | 심각 오류 (잘못 신고 / 놓침) | 사진당 시간 (최대) | 메모리 최대 | 모델 올리기 | 라이선스 |
|---|---|---|---|---|---|---|---|---|
| 1 | 채택 (기준 미달: 정확도, 심각 오류, 시간) | SSIM 기준 25 (더 예민) | **57.4%** (56% / 79% / 41%) | 11 (7 / 4) | 3.00초 (5.79초) | 341MB | 3.2초 | AGPL-3.0 (Ultralytics) |
| 2 | 탈락 (정확도, 심각 오류, 시간) | SSIM 기준 50 (덜 예민) | **53.2%** (50% / 71% / 41%) | 11 (8 / 3) | 3.13초 (5.63초) | 341MB | 3.0초 | AGPL-3.0 (Ultralytics) |
| 3 | 탈락 (정확도, 심각 오류, 시간) | 기준 밝기 자리마다 | **48.9%** (31% / 79% / 41%) | 15 (11 / 4) | 3.29초 (5.41초) | 336MB | 3.1초 | AGPL-3.0 (Ultralytics) |
| 4 | 탈락 (정확도, 심각 오류, 시간) | SSIM 기준 35 | **46.8%** (44% / 64% / 35%) | 13 (9 / 4) | 3.04초 (6.07초) | 339MB | 2.9초 | AGPL-3.0 (Ultralytics) |

#### 2026-11-11 13:55 · 정리 확인 후보 비교 (문제 47개, 후보 5개)

**채택:** 기준 v8s · 정확도 48.9% · 심각 오류 15 · 사진당 3.13초 · 메모리 336MB

목표: 정확도 95% 이상 · 심각 오류 0 · 사진당 10초 안

| 순위 | 판단 | 후보 | 정확도 (깨끗함 / 치울 것 / 두고 감) | 심각 오류 (잘못 신고 / 놓침) | 사진당 시간 (최대) | 메모리 최대 | 모델 올리기 | 라이선스 |
|---|---|---|---|---|---|---|---|---|
| 1 | 채택 (기준 미달: 정확도, 심각 오류) | 기준 v8s | **48.9%** (31% / 79% / 41%) | 15 (11 / 4) | 3.13초 (5.12초) | 336MB | 2.9초 | AGPL-3.0 (Ultralytics) |
| 2 | 탈락 (정확도, 심각 오류) | yolo11s | **46.8%** (38% / 64% / 41%) | 15 (10 / 5) | 2.74초 (4.80초) | 371MB | 2.4초 | AGPL-3.0 (Ultralytics) |
| 3 | 탈락 (정확도, 심각 오류) | yolo11s + YOLO-World 이름 | **40.4%** (31% / 57% / 35%) | 15 (11 / 4) | 2.90초 (5.58초) | 507MB | 2.6초 | AGPL-3.0 (Ultralytics) |
| 4 | 탈락 (정확도, 심각 오류) | v8s + YOLO-World 이름 | **40.4%** (25% / 57% / 41%) | 16 (12 / 4) | 3.33초 (5.46초) | 480MB | 2.9초 | AGPL-3.0 (Ultralytics) |
| 5 | 탈락 (정확도, 심각 오류) | yolov8m (참고, 느림) | **40.4%** (31% / 57% / 35%) | 16 (11 / 5) | 7.96초 (13.99초) | 452MB | 6.9초 | AGPL-3.0 (Ultralytics) |

후보 설정: 모두 `YOLO_MODEL=<모델> DESK_PHOTO=1 DESK_AREA=0.25,0.22,0.64,0.83 DESK_LIGHT=local ROOM_ITEMS=remote:1`, YOLO-World는 `LABEL_MODEL=gateway/yolov8s-worldv2.onnx` 추가

#### 2026-11-11 10:07 · 2판 재채점 (039 고친 뒤, 후보 3개, 요약)

| 순위 | 후보 | 정확도 (깨끗함 / 치울 것 / 두고 감) | 심각 오류 (잘못 신고 / 놓침) | 사진당 시간 |
|---|---|---|---|---|
| 1 | 밝기 자리마다, 기준 50 | 51.1% (31% / 79% / 47%) | 20 (11 / 9) | 3.10초 |
| 2 | 밝기 자리마다 | 48.9% (31% / 79% / 41%) | 15 (11 / 4) | 3.20초 |
| 3 | 밝기 자리마다 + 바닥 확대 | 48.9% (31% / 79% / 41%) | 15 (11 / 4) | 4.63초 |

#### 2026-11-11 09:48 · 2판 (정답지 고치기 전, 후보 6개, 요약)

| 순위 | 후보 | 정확도 (깨끗함 / 치울 것 / 두고 감) | 심각 오류 (잘못 신고 / 놓침) | 사진당 시간 |
|---|---|---|---|---|
| 1 | + 밝기 자리마다, 기준 50 | 51.1% (27% / 79% / 50%) | 20 (11 / 9) | 3.03초 |
| 2 | + 바닥 확대 (위치 틀림 0,0.6,1,1) | 51.1% | 20 (11 / 9) | 4.46초 |
| 3 | + 밝기 자리마다 | 48.9% (27% / 79% / 44%) | 15 (11 / 4) | 3.06초 |
| 4 | v8s + 책상 (의자 빼기) | 48.9% (20% / 79% / 50%) | 18 (12 / 6) | 3.05초 |
| 5 | + 기준 50, 작은 것 무시 | 46.8% (27% / 64% / 50%) | 24 (11 / 13) | 2.99초 |
| 6 | v8s만 + 바닥 확대 | 36.2% (87% / 7% / 17%) | 30 (2 / 28) | 2.70초 |

#### 2026-11-10 17:50 · 정리 확인 후보 비교 (문제 47개, 후보 2개)

**채택:** v8s + 책상 · 정확도 46.8% · 심각 오류 18 · 사진당 2.97초 · 메모리 336MB

목표: 정확도 95% 이상 · 심각 오류 0 · 사진당 1초 안

| 순위 | 판단 | 후보 | 정확도 (깨끗함 / 치울 것 / 두고 감) | 심각 오류 (잘못 신고 / 놓침) | 사진당 시간 (최대) | 메모리 최대 | 모델 올리기 | 라이선스 |
|---|---|---|---|---|---|---|---|---|
| 1 | 채택 (기준 미달: 정확도, 심각 오류, 시간) | v8s + 책상 (`DESK_PHOTO=1 DESK_AREA=0.25,0.22,0.64,0.83`) | **46.8%** (13% / 79% / 50%) | 18 (13 / 5) | 2.97초 (4.89초) | 336MB | 2.8초 | AGPL-3.0 (Ultralytics) |
| 2 | 탈락 (정확도, 심각 오류, 시간) | v8s (지금) | **36.2%** (93% / 0% / 17%) | 30 (1 / 29) | 1.33초 (1.55초) | 332MB | 1.8초 | AGPL-3.0 (Ultralytics) |

## 폴더 구조

```
firmware/uno_sensor_node/   우노 코드 (PIR · 조도 · 결과 LED) → 1번 방
firmware/esp32_room_node/   ESP32 메인 장치 (레이더 → 와이파이로 core 직접) → 2번 방
gateway/                    중계 (노트북·젯슨)
docs/                       배선도·회로도 (png, svg)
```
