AI-go-do/mspace-device/firmware/esp32_room_node/sender.cpp

#include "sender.h"
#include "config.h"
#include "net.h"
#include "server.h"

namespace sender {

// ---------- 큐 (고리 모양 배열) ----------
static Event queue[QUEUE_SIZE];
static size_t head = 0;   // 맨 앞(다음에 보낼 것) 위치
static size_t count = 0;  // 들어 있는 개수

size_t pending() { return count; }

void push(const Event& e) {
  if (count == QUEUE_SIZE) {  // 꽉 참: 가장 오래된 것(맨 앞)을 버린다. 최신 상태가 더 중요해서
    Serial.println("[전송] 큐가 꽉 차서 가장 오래된 이벤트를 버려요");
    head = (head + 1) % QUEUE_SIZE;
    count--;
  }
  queue[(head + count) % QUEUE_SIZE] = e;
  count++;
}

static void popFront() {
  head = (head + 1) % QUEUE_SIZE;
  count--;
}

// ---------- 한 건 보내기 ----------
enum Result { SENT, DROP, RETRY };

// 서버 응답 코드로 다음 행동을 정한다
// 버리는 건 "이 이벤트 자체가 잘못됐다"는 답(400·409·413·422)뿐이다.
// 401·403(토큰·방 설정), 404(서버에 아직 경로 없음), 408·429(바쁨), 3xx(주소 설정)는
// 장치나 서버 설정 문제라서 이벤트는 그대로 두고 간격을 늘려 다시 보낸다 (재실 기록이 사라지지 않게)
static Result classify(int status) {
  if (status >= 200 && status < 300) return SENT;  // STORED 또는 DUPLICATE. 둘 다 성공
  if (status == 400 || status == 409 || status == 413 || status == 422) {
    Serial.printf("[전송] 서버가 이 이벤트를 거부함(%d). 형식 문제라 이것만 버려요\n", status);
    return DROP;
  }
  if (status >= 300 && status < 400) {             // 리디렉션은 따라가지 않는다 (토큰이 다른 곳으로 가지 않게)
    Serial.printf("[전송] 리디렉션(%d)은 따라가지 않아요. SERVER_URL을 확인하세요. 큐는 그대로 둬요\n", status);
  } else if (status == 401 || status == 403) {
    Serial.printf("[전송] 막힘(%d): 토큰·ROOM_ID·DEVICE_ID를 확인하세요. 큐는 그대로 둬요\n", status);
  } else if (status == 404) {
    Serial.println("[전송] 막힘(404): 서버에 경로가 아직 없어요 (EVENT_PATH 확인). 큐는 그대로 둬요");
  } else {
    Serial.printf("[전송] 실패(%d). 같은 eventId로 다시 보내요\n", status);  // 408·429·5xx·연결 실패(음수)
  }
  return RETRY;
}

// ---------- 큐 처리 ----------
static unsigned long nextTryMs = 0;   // 다음에 보내 볼 시각 (millis)
static unsigned long backoffMs = RETRY_MIN_MS;

void update(unsigned long nowMs) {
  if (count == 0) return;
  const Event& e = queue[head];
  char json[320];

  if (server::mode() == server::MODE_DRY_RUN) {  // 연습: 화면에 찍고 바로 성공 처리
    eventToJson(e, net::epochNow(), nowMs, json, sizeof(json), true);
    Serial.print("[DRY_RUN] POST "); Serial.print(EVENT_PATH); Serial.print(' '); Serial.println(json);
    popFront();
    return;
  }
  if (!server::canSend() || !net::online()) return;    // 보낼 수 없으면 모아 두기만
  if ((long)(nowMs - nextTryMs) < 0) return;              // 아직 기다리는 중 (재시도 간격)
  if (!eventToJson(e, net::epochNow(), nowMs, json, sizeof(json))) {  // 시계가 맞춰질 때까지 기다림
    static unsigned long lastClockLogMs = 0;
    if (lastClockLogMs == 0 || nowMs - lastClockLogMs >= 60000UL) {  // 1분에 한 번만 찍는다
      lastClockLogMs = nowMs ? nowMs : 1;
      Serial.printf("[전송] 인터넷 시계(NTP)를 기다리는 중이라 못 보내요 (%u개 대기). 와이파이가 UDP 123을 막는지 확인하세요\n", (unsigned)count);
    }
    return;
  }

  Result r = classify(server::post(EVENT_PATH, json));
  if (r == RETRY) {
    nextTryMs = millis() + backoffMs;
    backoffMs = min(backoffMs * 2, RETRY_MAX_MS);
    return;
  }
  popFront();  // 성공이거나, 다시 보내도 소용없는 것
  backoffMs = RETRY_MIN_MS;
  nextTryMs = millis();
}

}  // namespace sender
