AI-go-do/mspace-device/firmware/esp32_room_node/occupancy.cpp

#include "occupancy.h"
#include "config.h"

void OccupancySensor::begin() {
#if USE_RADAR
  pinMode(PIN_RADAR, INPUT);
#endif
#if USE_PIR
  pinMode(PIN_PIR, INPUT);
#endif
}

OccupancyReading OccupancySensor::read(unsigned long nowMs) {
  OccupancyReading r = {false, -1, -1};
#if USE_RADAR
  r.radar = digitalRead(PIN_RADAR) == HIGH ? 1 : 0;
  if (r.radar == 1) r.occupied = true;
#endif
#if USE_PIR
  // PIR은 가만히 있는 사람을 못 봐서, 마지막 움직임 뒤 PIR_HOLD_MS(2분) 동안은 "있음"으로 본다
  if (digitalRead(PIN_PIR) == HIGH) {
    lastPirMotionMs_ = nowMs;
    pirMotionSeen_ = true;
  }
  if (pirMotionSeen_ && nowMs - lastPirMotionMs_ >= PIR_HOLD_MS) pirMotionSeen_ = false;  // 유지 시간이 끝나면 잊는다 (49일 뒤 millis 되감김에 다시 "있음"이 되지 않게)
  r.pir = pirMotionSeen_ ? 1 : 0;
  if (r.pir == 1) r.occupied = true;
#endif
  return r;
}

bool OccupancySensor::poll(unsigned long nowMs, OccupancyReading& out) {
  if (lastOccupied_ >= 0 && nowMs - lastReadMs_ < SENSOR_READ_MS) return false;  // 너무 자주 읽지 않는다
  lastReadMs_ = nowMs;

  OccupancyReading r = read(nowMs);
  bool changed = (int)r.occupied != lastOccupied_;
  bool beat = nowMs - lastSentMs_ >= OCCUPANCY_BEAT_MS;  // 빼서 비교하므로 millis()가 0으로 돌아가도 맞다
  if (!changed && !beat) return false;

  lastOccupied_ = r.occupied;
  lastSentMs_ = nowMs;
  out = r;
  return true;
}
