AI-go-do/mspace-device/(commit log)

2026-11-02 feat: 우노 키패드·센서 노드와 중계 코드, 배선도 추가
    FR-ACC-001 키패드 체크인을 위한 우노 코드(6자리 + #)와
    노트북 중계(gateway.py), 배선도·회로도, README를 올린다.
    Claude-Session: https://claude.ai/code/session_01YAvo4z861bezhzpTUetMdR
2026-11-02 chore: 레포 초기화
    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
2026-11-02 docs: 리뷰용으로 변수마다 주석 추가
    Claude-Session: https://claude.ai/code/session_01YAvo4zTU5AiyWQadpV6Eq8
2026-11-02 feat: 출입 확인 API를 core(지영) 형식에 맞춤
    - 요청: eventId(UUID), roomId, deviceId, code 4개 필드만 보냄
    - 응답: result == "OPENED"일 때만 열림, DENIED의 reason은 로그로 남김
    - eventId는 uuid5로 바꿔서 재전송해도 같은 값 유지 (중복 제거)
    - DRY_RUN도 OPENED/DENIED 형식으로 응답
    - 맥 호환 보드 포트(cu.usbserial, cu.wchusbserial) 자동 탐색
    - README 7장에 합의한 형식 반영
    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
2026-11-02 chore: CI, SonarQube Cloud, CodeRabbit 설정
    - GitHub Actions: 게이트웨이 테스트·커버리지, 펌웨어 컴파일, SonarQube 분석
    - main으로 가는 PR은 SonarQube 품질 게이트(새 코드 커버리지 80%) 통과해야 성공
    - 게이트웨이 테스트 10개 추가 (커버리지 98%)
    - CodeRabbit 한국어 리뷰 설정 (참고용)
    Refs #17
    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
2026-11-02 fix: 펌웨어 컴파일을 arduino-cli로 직접 실행
    compile-sketches 액션이 Ubuntu 26.04 러너에서 Python 3.12.4를 못 찾아 실패해서 바꿈
    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
2026-11-02 fix: arduino-cli 설치 폴더를 먼저 만듦
    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
2026-11-02 chore: SONAR_TOKEN이 없으면 SonarQube 분석을 건너뜀
    mspace-core CI와 같은 방식. 조직(ai-go-do)이 SonarQube Cloud에 만들어지기 전까지 CI가 빨간불이 되지 않게 함
    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
2026-11-02 chore: SonarQube Cloud 대신 학교 SonarQube 서버로 분석
    mspace-assistant와 같은 방식
    - 주소·토큰은 Secrets(SONAR_HOST_URL, SONAR_TOKEN), 프로젝트 키는 mspace-device
    - develop·main 합칠 때 분석, main으로 가는 PR은 품질 게이트를 기다려 실패하면 CI 실패
    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
2026-11-02 chore: CI를 손으로 돌릴 수 있게 workflow_dispatch 추가
    학교 SonarQube 서버 연결을 PR 없이 확인하기 위함
    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
2026-11-02 chore: CI에서 학교 SonarQube 서버 연결을 확인하는 단계 추가
    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
2026-11-02 refactor: 이번 PR은 키패드 체크인만 남김
    리뷰 양을 줄이려고 재실 센서(PIR·조도·레이더, /api/sensor-events)는 뺌.
    뺀 코드는 feat/8-sensor-events 브랜치에 그대로 보관, #8에서 다시 올림.
    Refs #3, #4
    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
2026-11-02 fix: 코드래빗 리뷰 반영 (로그에 번호 안 남김, CI 토큰 권한 제한, 부팅 횟수 bootId)
    - gateway: 출입 번호를 로그에 남기지 않고 eventId만 기록
    - gateway: 필드가 빠진 줄과 dict가 아닌 응답은 건너뛰거나 거부
    - gateway: 마지막 재시도 실패 뒤에는 기다리지 않음
    - ci: permissions contents read, checkout persist-credentials false
    - firmware: bootId를 EEPROM 부팅 횟수로 바꿔 재부팅 후 eventId 겹침 방지
    - firmware: Serial.setTimeout(50)으로 응답 대기 중 키패드 멈춤 줄임
    Claude-Session: https://claude.ai/code/session_01YAvo4zTU5AiyWQadpV6Eq8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
    [gateway.py, uno_sensor_node.ino]
2026-11-02 fix: 깨진 줄 로그에 번호 안 남김, 새 보드 bootId 랜덤 시작
    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
    [gateway.py, uno_sensor_node.ino]
2026-11-02 fix: 키패드 줄 형식 검사 (eventId 글자, roomId 정수, code 숫자 6자리)
    형식이 어긋난 줄이 to_uuid에서 TypeError로 게이트웨이를 멈추지 않게 한다.
    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
    [gateway.py]
2026-11-02 fix: eventId·code를 우노 형식(숫자-숫자-숫자, 0~9 6자리)으로만 받기
    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
    [gateway.py]
2026-11-02 fix: 장치 토큰 헤더 추가, 4xx는 재전송 안 함, 6자리 아닌 # 은 빨강 LED
    지영님 리뷰 반영
    - 서버 요청에 Authorization: Bearer <DEVICE_TOKEN> 헤더 추가 (DRY_RUN은 토큰 없이 동작)
    - 4xx 응답은 다시 보내도 같아서 바로 거부, 연결 실패·시간 초과·5xx만 재시도
    - 6자리가 아닌 상태에서 # 을 누르면 빨강 LED
    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
    [gateway.py, uno_sensor_node.ino]
2026-11-02 ci: 외부 액션을 커밋 SHA로 고정 (#19)
    태그는 옮겨질 수 있어서 같은 버전 이름이 다른 코드를 가리킬 수 있다.
    assistant와 같은 방식으로 SHA를 적고 옆에 버전을 주석으로 남긴다.
    Claude-Session: https://claude.ai/code/session_011gK1KhTVDV3mCUZsaVggeQ
2026-11-03 fix: LED 대기 없애기 + 게이트웨이 역할별로 나누기 (#20)
    * fix: LED를 millis()로 켜고 끄기, 켜져 있는 동안에도 키 입력 받기
    delay(1500) 동안 loop()가 멈춰서 그사이 누른 키가 사라지던 문제 (지영 리뷰).
    LED 켠 시각만 기억하고 loop()마다 1.5초 지났는지 확인해서 끈다.
    배선 주석을 키패드 라벨(R1~R4, C1~C4) 기준으로 고침.
    * refactor: 게이트웨이를 역할별로 나누기 (Config, verifier, handle_line)
    재웅 리뷰 반영. 동작은 그대로다.
    - Config, load_config()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
    [gateway.py, uno_sensor_node.ino]
2026-11-03 docs: 키패드 ↔ core 통신 형식 문서 초안 (FR-ACC-001)
    4차 회의 할 일. 시리얼 줄, /api/access/verify 요청·응답, 오류 처리,
    eventId 중복 거르기를 한곳에 모으고, 지영·재웅에게 확인할 것을 표로 정리.
    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
2026-11-03 docs: core API 명세(docs api/README 6장)에 맞춰 reason·오류 코드 고치기
    NOT_YET·LOCKED·DEVICE_UNAUTHORIZED·INVALID_REQUEST는 core에 이미 있어서 확정으로 바꾸고,
    남은 확인 질문을 3개로 줄임.
    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
2026-11-03 docs: 리뷰 반영 (NOT_YET 문구, HTTPS 안내, README 7장 정리)
    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
2026-11-03 docs: 지영 리뷰 반영 (WRONG_CODE 경우, 같은 eventId 응답, 요구사항 질문은 재웅)
    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
2026-11-04 feat: 확인 중 LED 깜빡임 + 서버 대기 줄이기 (최대 12초 → 5초)
    - 우노: # 누르면 답이 올 때까지 초록 LED 깜빡임 (millis 기준, 키 입력은 계속 받음)
    - 우노: 7초 넘게 답이 없으면 스스로 빨강 LED (USB 빠짐·게이트웨이 꺼짐 대비)
    - 게이트웨이: 재시도 3초×3번 → 2초×2번 (TIMEOUT 상수로 분리)
    - 문서: 재시도 횟수·최대 대기 시간 고침
    Refs #6
    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
2026-11-04 fix: 지영 리뷰 반영 (연결 시간 따로 재기, 확인 중 # 무시)
    - 게이트웨이: timeout=(연결 1초, 답 2초). 최악 (1+2)×2 + 1 = 7초
    - 우노: WAIT_MAX_MS 7초 → 9초 (늦은 OK가 빨강을 뒤집지 않게)
    - 우노: 확인 중에 누른 #은 무시 (번호 두 번 전송, 빨강+깜빡임 겹침 막기)
    - 테스트·문서 시간 계산 맞춤
    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
    [gateway.py, uno_sensor_node.ino]
2026-11-04 docs: 재실·CO2 센서 → core 통신 형식 초안 (FR-DEV-101~104)
    - POST /api/sensor-events: OCCUPANCY(바뀔 때 + 5분마다), CO2(1분마다)
    - 장치 안 수신기 인터페이스: 센서 종류는 장치가 숨기고 core는 공통 모양만 받음
    - 응답·오류·재시도는 키패드(access-api.md)와 같은 규칙
    - core 할 일과 정할 것 목록 (지영·재웅)
    Refs #7
    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
2026-11-04 docs: CodeRabbit 리뷰 반영 (토큰-방 묶기, 늦게 온 이벤트, 응답 예시, source 칸, HTTPS)
    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
2026-11-04 docs: CodeRabbit 2차 리뷰 반영 (https 예시, 오류 본문 형식, CO2 연속 간격)
    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
2026-11-04 gateway: 원격 http 주소 거부, 기본 주소 8411 + CO2 연속 최소 간격
    - is_safe_server(): https 또는 loopback http만 허용, 아니면 시작 안 함 (토큰 평문 전송 방지)
    - Config.server 기본값을 로컬 core 포트 8411로 맞춤
    - CO2 3분 연속: 이웃 값 간격 30~90초일 때만 연속
    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
2026-11-04 docs: access-api에 게이트웨이 https 강제 동작 적기
    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
2026-11-05 gateway: 기본 주소를 8080으로 되돌림 (수연 결정)
    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
2026-11-05 docs: 재실 살아 있음 신호 10초, 끊김 판단 1분 (이슈 #8에 맞춤)
    Refs #7, #8
    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
2026-11-05 fix: CodeRabbit 4차 리뷰 반영 (리디렉션 거부, localhost 프록시 우회, CO2 연속 최소 범위)
    - HttpVerifier: allow_redirects=False, 3xx는 다시 보내지 않고 거부
    - localhost로 보낼 때는 환경 프록시를 거치지 않음 (is_loopback 분리)
    - CO2 3분 연속: 첫 값~마지막 값 100초 이상
    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
    [gateway.py]
2026-11-05 docs: CodeRabbit 5차 리뷰 반영 (신호마다 새 eventId, CO2 방별 한 줄, 끊김 뒤 늦은 이벤트)
    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
2026-11-05 feat: 재실 센서 준비 (우노 PIR·조도 + ESP32 메인 장치 뼈대)
    - 우노: PIR(D2)·조도(A0)를 바뀔 때와 10초마다 occupancy 줄로 출력
    - 게이트웨이: occupancy 줄을 core 형식(kind OCCUPANCY, occupied, sources, observedAt)으로 바꿔 출력 (서버 전송은 주소 확정 뒤)
    - ESP32 메인 장치(firmware/esp32_room_node): 레이더·PIR 합치기, 새 UUID eventId,
    NTP 시각, 큐 + 재시도(5xx), 4xx·리디렉션 버림, https 인증서·토큰 없으면 전송 막기. 기본 DRY_RUN
    - 배선도: ESP32 + LD2410C 새로 그림, 우노 D3 비움(레이더는 ESP32로), 키패드 라벨 기준 안내
    - 테스트 50개 통과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
2026-11-05 fix: CodeRabbit·지영 리뷰 반영 (원격 core 예시 https, 센서 0개면 컴파일 막기, 큐 5분 안내)
    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
    [config.h, gateway.py]
2026-11-05 fix(esp32): 설정 문제(401·403·404 등)는 큐를 지키고 재시도, TLS 타임아웃·시계 대기 로그 추가
    재웅님 리뷰 반영:
    - 400·409·413·422만 버리고 401·403·404·408·429·3xx는 큐 유지 + 백오프
    - WiFiClientSecure 핸드셰이크 5초 제한
    - NTP 대기 중 1분마다 로그
    - 토큰 주석을 현재 core(공용 토큰 1개)에 맞게 수정
    - 루트 인증서는 ISRG Root X1+X2만 넣도록 안내
    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
    [config.h, sender.cpp, sender.h]
2026-11-05 fix(esp32): http 시험은 사설 주소·.local만 허용, access-api에 재실 센서 줄 추가
    CodeRabbit 리뷰 반영:
    - ALLOW_HTTP_FOR_LOCAL_TEST 1이어도 호스트가 사설 IP(10/8, 172.16/12, 192.168/16)나 .local이 아니면 막음
    - docs/access-api.md 2장에 sensorType occupancy 줄 형식 추가
    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
    [sender.cpp]
2026-11-05 docs: 센서 401·403·404는 버리지 않고 재시도로 (재웅님 #24 리뷰), docs #38 링크
    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
2026-11-05 fix(esp32): 주소 어디에든 @가 있으면 http 시험 막기, 우노 센서 전송 조건 문서화
    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
    [sender.cpp]
2026-11-05 docs: docs #38 절 번호 6-2로
    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
2026-11-05 feat: PIR은 마지막 움직임 뒤 2분간 있음 유지 (우노·ESP32)
    HC-SR501은 움직임만 봐서 가만히 공부하는 사람을 '없음'으로 본다.
    FR-DEV-103 '헷갈리면 있음'에 맞게 PIR_HOLD_MS(120초) 동안 있음을 유지한다.
    레이더는 그대로. README에 점퍼 H, 조도 1023 배선 확인 안내 추가.
    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
2026-11-05 feat(gateway): 재실 이벤트를 core POST /api/sensor-events로 전송 (SEND_SENSORS=1)
    - SensorSender: 큐(최대 360개) + 별도 스레드, 키패드 응답을 막지 않음
    - ESP32와 같은 규칙: 2xx 성공, 400·409·413·422만 버림, 나머지는 같은 eventId로 1→30초 재시도
    - 리디렉션 따라가지 않음 (토큰 보호)
    - core #60이 올라가기 전까지는 기본 꺼짐
    - 테스트 16개 추가 (전체 66개)
    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
2026-11-05 fix(gateway,firmware): 원격 http 서버 거부, PIR 유지 만료 시 초기화, README 폐기 코드 정정
    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
    [gateway.py, occupancy.cpp, uno_sensor_node.ino]
2026-11-05 docs: 자리 비움 규칙에 '아직 있어요' 버튼 반영 (docs #39)
    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
2026-11-05 docs: README 진행표 자리 비움 줄 맞추기
    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
2026-11-06 feat(gateway): 문 앞 웹캠 QR 입실 (QR_CAMERA)
    - 8차 회의(11/6)에서 시연을 카메라 + QR로 바꿈. 키패드는 그대로 둠
    - qr_door.py: 웹캠에서 QR을 읽어 키패드와 같은 /api/access/verify로 확인, 결과는 우노 LED(OK/NO)
    - QR 글자: 6자리 입실 번호 또는 MSPACE:<방>:<번호>. 다른 방 QR은 서버에 묻지 않고 거부
    - 같은 QR 5초 안 반복은 무시, 사진·영상은 저장·전송 안 함
    - core 변경 없이 지금 입실 번호로 바로 시연 가능
    - 테스트 99개 통과 (OpenCV 없이 가짜 카메라)
    Claude-Session: https://claude.ai/code/session_01YAvo4zTU5AiyWQadpV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
2026-11-06 feat(gateway): 방 안 웹캠 인원 세기와 퇴실 뒤 정리 확인
    - room_camera.py: YOLOv8 ONNX(없으면 HOG)로 사람 수를 세서 기존 OCCUPANCY 이벤트로 보냄 (sources.people)
    - 사람이 다 나가고 30초 뒤 빈 방 기준과 비교해 CLEAN / NEEDS_CLEANING / LEFT_ITEMS 판정, room_checks.jsonl에 기록
    - 카메라가 있는 방은 우노 PIR 값을 카메라 이벤트에 합쳐 보냄
    - 사진·영상은 저장하거나 보내지 않음
    - 테스트와 README 추가
    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
2026-11-06 fix(gateway): 카메라 한 장에서 오류가 나도 QR·인원 세기 스레드가 계속 돌게 함
    PR #26 리뷰 제안 반영: 탐지·처리 중 예외를 로그로 남기고 다음 장으로 넘어감
    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
    [qr_door.py, room_camera.py]
2026-11-06 fix(gateway): QR 카메라를 못 열면 시작할 때 알리고, 숫자는 0-9만 받음
    CodeRabbit(#26) 지적 반영
    - start_qr: 스레드 전에 카메라를 열어 실패를 숨기지 않음
    - QR_ROOM_ID, ROOM_CAMERA_ROOM: ², ١ 같은 글자로 시작이 멈추지 않게 함
    - QR 번호: 0-9 숫자만 받음
    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
    [gateway.py, qr_door.py]
2026-11-06 fix(gateway): 젯슨 OpenCV 4.6에서도 YOLOv8이 돌게 onnxruntime 먼저 사용
    젯슨 B(apt OpenCV 4.6.0)에서 readNetFromONNX가 YOLOv8 출력부를 못 읽음(shape_utils total assertion).
    onnxruntime이 있으면 그걸로 추론하고, 없으면 기존 OpenCV DNN을 씀. README에 venv 설치 안내.
    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
    [room_camera.py]
2026-11-06 feat(gateway): 쓰러짐 감지(이상 탐지)와 우노 없이 카메라만 실행
    - FallWatcher: 누운 자세(가로>세로×1.2)로 같은 자리에 FALL_SEC(기본 15초) 넘게 있으면 FALL_SUSPECTED, 일어나면 FALL_CLEARED.
    core 알림 API가 없어 재실 이벤트 sources.alert로 남기고 room_checks.jsonl에 기록 (8차 회의 멘토 '쓰러짐 감지')
    - 우노가 없어도 QR·방 안 카메라를 켰으면 카메라만 돌림. QR 결과는 화면에 표시
    - 테스트·README
    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
2026-11-06 fix(gateway): 리뷰 반영 - PIR·카메라 신선도, 쓰러짐 3초 유예, 로그 실패 분리, QR 답 재전송
    - LAST_PIR에 받은 시각을 함께 두고 30초 넘으면 쓰지 않음
    - CAMERA_ROOMS를 마지막 정상 프레임 시각으로 관리, 30초 넘게 못 읽으면 우노가 다시 재실 전송
    - 방 안 카메라 읽기 실패를 10초 간격으로 알림
    - FallWatcher: 누운 사람을 3초 넘게 연달아 못 찾을 때만 초기화·해제
    - 쓰러짐 알림은 core 전송 후 기록, 기록 실패(OSError)는 따로 처리
    - QR 답 시리얼 쓰기 실패는 프레임 오류와 분리해 3번까지 다시 보냄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
    [gateway.py, qr_door.py, room_camera.py]
2026-11-06 fix(gateway): 리뷰 반영 - 찾기 성공한 장만 카메라 살아 있음, PIR만 바뀌어도 바로 전송, 쓰러짐 상자 흔들림 유예
    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
    [room_camera.py]
2026-11-06 revert(gateway): 쓰러짐 감지 빼기 (요청하지 않은 기능)
    인원 세기·정리 확인·우노 없이 실행·리뷰 반영은 그대로 둔다.
    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
    [gateway.py, room_camera.py]
2026-11-06 feat(gateway): 방 안 카메라 화면 브라우저로 보기 (PREVIEW_PORT, 기본 꺼짐)
    찾은 사람·물건 상자와 사람 수를 그린 화면을 MJPEG로 보여 준다. 저장·전송 없음.
    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
2026-11-06 fix(gateway): 화면 보기 포트가 겹쳐도 카메라는 계속 (젯슨 B 8080 사용 중 → 8090 안내)
    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
    [gateway.py]
2026-11-06 fix(gateway): 화면 보기 리뷰 반영 - 기본 127.0.0.1(PREVIEW_HOST로 Tailscale만), 포트 범위 오류 처리, 화면 오류가 인원 세기를 막지 않게
    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
    [gateway.py, room_camera.py]
2026-11-06 feat(gateway): 붙어 앉은 두 사람을 한 명으로 합치지 않게 + 모델 v8s 안내
    사람끼리는 NMS 겹침 기준을 0.45에서 0.6으로 느슨하게 둔다.
    README 모델 안내를 yolov8s로 바꾼다 (노트북·폰을 덜 놓침).
    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
2026-11-06 fix(gateway): PIR이 움직임을 느끼는 동안은 정리 확인을 미룬다
    카메라 사각지대에 사람이 있는데 0명으로 보고 정리 확인을 해 버리는 것을 막는다.
    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
    [room_camera.py]
2026-11-06 feat(gateway): 물건은 점수 0.3부터 잡고, 미리보기 글자를 화면 폭에 맞춰 키움
    사람은 0.4 그대로 둔다 (잘못 세면 재실이 틀림).
    늘 있는 엉뚱한 물건은 빈 방 기준과 비교할 때 빠진다.
    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
2026-11-06 feat(gateway): 정리 확인 때만 4조각으로 자세히 보고, 깨끗한 방 기준 저장을 알림
    - 기준 저장·정리 확인 때 한 장 전체 + 네 귀퉁이 조각을 찾아 합친다 (멀리 있는 작은 물건)
    조각 경계에 잘린 물건, 이미 찾은 물건은 빼서 두 번 세지 않는다
    - 기준을 저장하면 BASELINE_SAVED로 알린다
    - 기준 없이 퇴실하면 전부 새 물건으로 잡지 않고 그때 모습을 기준으로 저장한다
    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
2026-11-06 feat(gateway): 정리 확인을 자리 대신 종류별 개수로 비교 + 방 비품(ROOM_ITEMS)
    - 리모컨을 조금 옮겨도 새 물건으로 잡지 않는다
    - ROOM_ITEMS=remote:1 이면 리모컨 0~1개는 괜찮다 (바구니에 넣어 안 보여도, 책상에 나와 있어도)
    - 깨끗한 확인 뒤 기준은 줄이지 않고 넓히기만 한다
    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
2026-11-06 docs: README 문장 다듬기
    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
2026-11-06 feat(gateway): 퇴실하면 정리 확인 + 결과를 core로 보냄 (core #81)
    - SEND_SENSORS=1이면 10초마다 GET /api/rooms/{id}/current를 묻고 lastEnded가 바뀌면
    방이 10초 비었을 때 확인한다. 다 같이 화장실 가도 예약이 안 끝났으니 확인하지 않는다
    - 결과는 POST /api/rooms/{id}/tidy-checks (치울 것 → NEEDS_CLEANING, 가방·휴대폰 → leftItems)
    같은 큐 전송기(SensorSender)를 쓰고 404·409는 버린다
    - 퇴실 뒤 10분 안에 방이 비지 않으면 그 예약은 건너뛴다 (다음 사람 물건을 탓하지 않게)
    - DRY_RUN은 지금처럼 30초 빈 방 연습 모드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
2026-11-06 feat(gateway): 깨끗한 방 기준을 파일에 저장 + 젯슨 켜지면 자동 실행(systemd) + 노트북을 LAPTOP으로 보냄
    - room_baseline.json에 기준을 적어 두어 껐다 켜도 남음 (BASELINE_FILE=off면 메모리만)
    - deploy/install-service.sh: systemd 서비스 설치, 꺼지면 5초 뒤 다시 켬, 출력은 gateway.log
    - PREVIEW_HOST=tailscale: Tailscale 주소를 알아서 찾음
    - core #81에 LAPTOP이 추가되어 노트북도 leftItems로 보냄
    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
2026-11-07 feat(esp32): 시험용 키패드 체크인 (USE_KEYPAD 스위치) (#25)
    * feat(esp32): 시험용 키패드 체크인 (USE_KEYPAD 스위치)
    - 2번 방 ESP32에서도 키패드 체크인을 시험할 수 있게 함 (두 방 동시 운영 확인용)
    - config.h의 USE_KEYPAD 0이면 키패드 코드가 통째로 빠짐 (발표·운영 전 끄기)
    - 서버 설정 확인·POST를 server.*로 분리해 재실 전송(sender)과 키패드 확인(access)이 같이 씀
    - 키패드 확인 규칙은 게이트웨이와 같음: 같은 eventId로 최대 2번, 4xx·리디렉션은 바로 거부, 애매하면 거부
    - CI에 ESP32 컴파일 추가 (키패드 켬·끔 둘 다)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
2026-11-07 feat(gateway): 책상 확대 + 깨끗한 책상 사진 비교로 남은 물건 찾기 (#28)
    * feat(gateway): 정리 확인 때 책상 부분(DESK_AREA)을 확대해서 한 번 더 봄
    * feat(gateway): 깨끗한 책상 사진과 비교해서 모델이 모르는 물건도 찾기 (DESK_PHOTO, 기본 꺼짐)
    - desk_diff.py: 사람 0명일 때 찍은 책상 사진(흑백, 젯슨에만)과 퇴실 뒤 책상의 달라진 곳을 OpenCV로 찾음
    - 달라진 곳에 모델로 이름을 붙이고, 못 붙이면 '모르는 물건'(치울 것)
    - 모델이 이미 센 물건,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
2026-11-07 fix(gateway): 물건 하나에 이름이 두 개 붙으면 점수 높은 것만 남기기 (#29)
    11/7 방 사진 4장 모두에서 모델이 책상 리모컨을 "리모컨"과 "휴대폰"으로
    거의 같은 상자에 동시에 봤다. 리모컨은 방 비품이라 빠지지만 "휴대폰"이
    새로 생긴 물건으로 세어져 깨끗한 방에서 "휴대폰 두고 감"이 갈 수 있었다.
    nms에서 이름이 다른 물건 두 상자가 IoU 0.8 이상이면 같은 물건으로 보고
    점수 높은 쪽만 남긴다. 사람은 손에 든 물건과 겹칠 수 있어 따로 둔다.
    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
    [room_camera.py]
2026-11-09 feat(gateway): 정리 확인 기준을 입실 직전 빈 방으로 (Q-22 B안) (#32)
    * feat(gateway): 정리 확인 기준을 입실 직전 빈 방으로 (Q-22 B안)
    - 퇴실 모드: 한 장씩 0명이 연속 3초면 빈 방 후보를 메모리에 들고(1분마다 새로), 사람이 처음 보이면 그 예약 기준으로 확정
    - 퇴실 뒤 비교는 예약 기준과. 앞 팀이 두고 간 것을 다음 팀 탓으로 하지 않음
    - 잠깐 다 나갔다 오면(화장실) 처음 기준 유지. 퇴실 알림 뒤 다음 팀이 10초 전에 들어오면 앞 예약 건너뜀
    - 기준이 없으면 SKIPPED(서버로 안 보냄, 어질러짐 신고가 받음). 10분 넘게 안 비면 그 예약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
    [desk_diff.py, gateway.py, room_camera.py]
2026-11-09 카메라 재실 이벤트에 우노 조도(sources.light) 같이 보내기 (#35)
    카메라가 켜져 있으면 우노 재실 줄은 PIR만 남기고 조도는 버려졌다.
    마지막 조도를 방별로 기억했다가(30초 안 값만) 카메라 OCCUPANCY 이벤트의
    sources.light에 붙인다. core는 sources를 기록만 하므로 재실 판단은 그대로.
    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
2026-11-09 feat(gateway): 교육장 MQTT 센서 값을 방 CO2·온도·습도로 보내기 (Q-21 시연) (#33)
    * feat(gateway): 교육장 MQTT 센서 값을 방 CO2·온도·습도로 보내기 (Q-21 시연)
    실습실에 이미 있는 MQTT 센서를 M-SPACE 1번 방으로 치고 core 센서 API(kind CO2 +
    temperatureC·humidityPct)로 1분마다 보낸다. MQTT_ROOM을 줄 때만 켜지고, 구독만 한다.
    - 토픽 application/+/device/+/event/up, QoS 1, clean_session=False, keepalive 30
    - (devEui, fCnt) 중복 한 번만, 30초 넘는 미래 시각은 받은 시각으로
    - 기기별 최근 값 → 공간 평균, 5분 넘게 안 온 기기는 뺌
    - 새 값이 온 분에만 보냄 (CO2 3분 연속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
2026-11-09 가짜 교육장 센서와 MQTT 방 여러 개 지원 (시연용) (#36)
    * 가짜 교육장 센서와 MQTT 방 여러 개 지원
    진짜 센서 업링크가 멈췄을 때 시연할 수 있게 젯슨 안 브로커(localhost)에만
    방마다 ChirpStack 형식 업링크를 1분마다 올리는 fake_env_sensors.py를 추가한다.
    공용 브로커에는 올리지 않고(localhost 외 거부), CO2는 950ppm을 넘지 않는다.
    게이트웨이는 MQTT_ROOMS="가상-1:1,..."로 접속 하나에서 방 여러 개를 받는다(RoomRouter).
    * 방마다 전송 줄 따로 두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
2026-11-09 정리 확인 채점·후보 비교 도구 (정확도·심각한 오류·시간·메모리) (#37)
    * 정리 확인 채점 도구: 시험 사진 쌍으로 정확도·심각한 오류·시간 재기
    - tidy_eval.py capture: 입실 전 빈 책상 + 퇴실 뒤 사진과 정답을 eval/tidy/에 모음 (사람이 보이면 저장 안 함)
    - tidy_eval.py score: 게이트웨이와 같은 설정으로 퇴실 모드와 같은 판정을 돌려 채점, README 실험 기록 줄을 만들어 줌
    - eval/는 .gitignore (젯슨 안에만)
    - README: 채점 방법, 9. 실험 기록 표
    Claude-Session: https://claude.ai/code/session_01YAvo4zTU5AiyWQadpV6Eq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
2026-11-10 README: 11/10 기준 진행 상황·앞으로 할 것·설계 패턴(발표용) (#40)
    * README: 11/10 기준 진행 상황·앞으로 할 것·설계 패턴(발표용) 정리
    10차 회의(요구사항 v0.4.33) 반영: FR-DEV-105~107 추가, 센서 어댑터·기기 파사드 그림.
    * README: 운영 줄 PR 번호
    ---------
    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
2026-11-10 가짜 센서를 방마다 1대로 줄이기 (#38)
    M-SPACE 방 하나에 센서 하나라 시연 때 헷갈리지 않게 맞춘다. 서버로 가는 값(방마다 평균 하나)은 그대로.
    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
2026-11-10 README: 앞으로 할 일 표는 빼고 확장 계획으로 옮기기 (#41)
    README에는 결과와 쓰는 법만 두고, 할 일은 노션 작업 기록에 둔다.
    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
2026-11-10 센서 어댑터의 공통 모양을 코드에 명시 (동작 그대로) (#39)
    센서마다 다른 입력(우노 시리얼, MQTT, 방 카메라)을 core 이벤트 한 모양으로 바꿔
    push 한 곳으로 보내는 구조를 sensor_adapters.py에 이름으로 적었다 (10차 회의, FR-DEV-101).
    시험이 세 어댑터가 정말 이 모양으로 내보내는지 확인한다.
    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
2026-11-10 정리 확인: 두고 간 물건을 종류 구분 없이 LEFT_ITEMS로, 2시간 뒤 다시 확인 (10차)
    - tidy_body: result CLEAN|LEFT_ITEMS, items는 물건마다 {name, confidence}, phase FIRST|RECHECK
    - 첫 확인에서 남은 게 있으면 기준 개수를 남겨 두고, 서버 recheck 시각이 지나면 다시 비교
    - CheckoutPoller가 current의 recheck {reservationId, at}를 읽어 한 번만 다시 확인을 부름
    - 확신도는 같은 종류 중 낮은 점수부터, 책상 사진 비교로만 찾은 것은 0.5
    core 쪽(지영) 변경과 같이 배포해야 한다.
    Claude-Session: https://claude.ai/code/session_01YAvo4zTU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
2026-11-10 chore: 키패드 체크인 코드 빼기 (입실은 QR 하나) (#43)
    * chore: 키패드 체크인 코드 빼기 (입실은 QR 하나)
    11/10 키패드 해제에 맞춰 키패드 관련 코드와 설명을 지운다.
    - 게이트웨이: keypad 처리기 삭제. 옛 우노가 keypad 줄을 보내도 건너뛴다. 확인기(DryRun/Http)는 QR이 쓰므로 남김
    - 우노: Keypad 라이브러리·입력·깜빡임 삭제. OK/NO 결과 LED는 QR용으로 남김
    - ESP32: checkin·keypad_door 파일과 USE_KEYPAD 설정 삭제
    - CI: Keypad 라이브러리 설치와 키패드 켬·끔 두 번 컴파일 삭제
    - 문서: access-api.md를 QR 기준으로, README·sensor-events-api.md 표현 정리
    Co-A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
2026-11-10 fix: 다시 확인은 recheck 시각 1분 뒤에 (시계 차이로 TOO_EARLY 409가 나지 않게)
    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
    [gateway.py]
2026-11-10 docs: 배선도·회로도에서 키패드 빼기 (#44)
    11/10 키패드 해제에 맞춰 우노 배선도·회로도에서 키패드와 D11~D4 선을 지우고 '비움'으로 적었다.
    LED는 QR 결과 표시용으로 남김. png는 svg에서 다시 뽑음(2배).
    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
2026-11-10 fix: 다시 확인 대기를 퇴실 확인과 따로 두고, 서버가 빼면 취소
    - RoomWatcher.recheck_pending: RECHECK 대기를 FIRST의 pending과 분리. 기다리는 동안 방에 있는 사람의
    예약 기준(entry)을 지우거나 바꾸지 않고, 시각 뒤 10분 동안 방이 안 비면 건너뜀. 퇴실 확인이 먼저
    - cancel_recheck + CheckoutPoller.on_recheck_gone: 다음 팀 입실로 서버가 recheck를 빼면 기다리던 다시 확인 취소
    - README: recheck가 빠지는 때(입실 기준), 장치 안 분류와 서버로 보내는 결과(LEFT_ITEMS) 구분
    - 시험 4개 추가 (320 통과)
    Claude-Session: h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
    [gateway.py, room_camera.py]
2026-11-10 docs: 다시 확인 10분 시작점과 개수만 비교하는 한계 적기
    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
2026-11-10 fix: 퇴실 뒤 누가 들어오면 다시 확인 안 함, 서버가 시각을 늦추면 따라감
    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
    [gateway.py, room_camera.py]
2026-11-10 fix: 퇴실 확인 폴링이 예외로 멈추지 않게
    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
    [gateway.py]
2026-11-10 docs: 다시 확인 2시간 → 3시간 (core #113)
    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
2026-11-10 fix: PIR이 오래 켜진 입실에서도 앞 예약 다시 확인 취소
    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
    [room_camera.py]
2026-11-10 feat: 채점표에 잘못 신고·놓침 나누기, 기준 못 넘어도 가장 나은 후보 채택 표시, README 실험 기록 최신이 위
    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
2026-11-10 docs: README 실험 기록을 판별 기록·채점 확인 표 모양으로
    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
2026-11-10 feat: 비교표에 순위 칸과 맨 위 채택 요약 한 줄
    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
2026-11-10 docs: 정리 확인 1판 채점 결과 (기준선 2개)
    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
2026-11-10 fix: 책상 비교에서 의자 같은 가구는 세지 않기 (#47)
    1판 채점에서 깨끗한 쌍 3개(003, 008, 014)가 의자 자리 바뀜 때문에 '치울 것'이 됐다.
    달라진 곳에 가구 이름(chair 등)이 붙으면 정리 대상이 아니라 건너뛴다.
    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
    [room_camera.py]
2026-11-10 feat: 책상 비교 예민한 정도를 설정으로 (DESK_LIGHT, DESK_THRESH, DESK_MIN_AREA) (#48)
    1판 채점에서 깨끗한 쌍 7개가 '모르는 물건'만으로 잘못 신고됐다(그대로 둔 002, 004 포함).
    DESK_LIGHT=local은 자리마다 밝기를 고르게 한 뒤 비교해 한쪽 그늘·빛을 지운다.
    기본값은 지금과 같아서 켜지 않으면 바뀌는 것이 없다. 채점 후보 이름에도 새 설정을 적는다.
    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
2026-11-10 feat: 정리 확인 때 바닥 부분도 확대해서 보기 (FLOOR_AREA) (#49)
    * feat: 정리 확인 때 바닥 부분도 확대해서 보기 (FLOOR_AREA)
    1판 채점에서 놓친 5개 중 4개(036 가방, 045 에어팟 케이스, 047 틴트 등)가 바닥에 있었다.
    FLOOR_AREA를 주면 책상 확대와 같은 방법으로 바닥도 잘라 한 번 더 찾는다. 미리보기에 floor 상자를 그린다.
    기본은 꺼져 있어 지금과 같다.
    * fix: 아주 작은 확대 부분이면 빈 조각은 모델에 넣지 않기
    CodeRabbit 지적: DESK_AREA·FLOO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
    [gateway.py, room_camera.py, tidy_eval.py]
2026-11-11 chore: 정리 확인 채점 목표 시간을 사진당 1초 → 10초로
    정리 확인은 퇴실 뒤 한 번만 보고 이미 10초 빈 방을 기다리므로 10초면 충분 (11/11 수연 결정).
    시연 때는 정확도가 비슷하면 빠른 후보를 쓴다.
    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
2026-11-11 feat: 정리 확인 때 사람 없는 빈 방 사진을 core에 올리기 (TIDY_PHOTOS, docs Q-27) (#51)
    입실 전(ENTRY)·퇴실 뒤(FIRST)·3시간 뒤(RECHECK) 사진을 결과 다음에
    POST /api/rooms/{room}/tidy-photos (core #115)로 multipart 전송.
    사람이 보이는 장은 안 올리고, 기본은 꺼짐.
    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
2026-11-11 feat(tidy_eval): 깨끗함/남음 정확도를 추가하고 순위·합격 기준으로 사용
    사용자에게는 쓰레기와 두고 간 물건을 구별하지 않고 알리므로,
    둘이 바뀐 것은 깨끗함/남음 정확도에서 맞음으로 센다.
    세 가지 정확도는 참고로 표에 함께 남긴다.
    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
2026-11-11 docs: README 실험 기록에 2판·3판 채점 결과 추가 (#52)
    * docs: README 실험 기록에 2판·3판 채점 결과 추가 (11/11)
    * docs: 3판을 후보마다 한 줄로 (1판과 같은 모양)
    * docs: 실험 기록 표현 바로잡기 (원인은 추정, 2판 채택 이유, 1판은 정답지 고치기 전)
    Claude-Session: https://claude.ai/code/session_01YAvo4zTU5AiyWQad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
2026-11-11 docs(README): 5판 결과와 깨끗함/남음 정확도 칸 추가
    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
2026-11-11 docs(README): 진행 상황 표를 11/11 기준으로 (#42~#54 반영)
    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
2026-11-11 docs(README): 키패드·QR 두 방식을 비교해 QR을 채택한 것으로 설명
    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
2026-11-11 docs(README): 정리 확인 6판 결과 (치운 자리 빼기·밝기 맞추기)
    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
2026-11-11 docs(README): 정리 확인 7판 결과 (DINOv2 특징 비교)
    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
2026-11-12 docs(README): 정리 확인 8·9·10판 결과 (#58)
    * docs(README): 정리 확인 9판 결과 (옮김 빼기 기준·잘라서 비교)
    * docs(README): 정리 확인 10판 결과 (VLM 2차 확인)
    * docs(README): 정리 확인 8판 결과 (옮김 빼기)
    * docs(README): 8판 비교표 원본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
2026-11-12 feat(gateway): PIR 빼고 조도만 쓰기 + 전송 성공 줄 (#59)
    * feat(gateway): PIR을 기본으로 안 쓰고 조도만 싣기 (USE_PIR=1로 다시 켬)
    PIR 선을 뺀 우노 D2 핀은 공중에 떠서 1로 읽힐 수 있어, 빈 방을 있음으로 보고
    정리 확인을 막지 않게 PIR 값을 버린다. 조도는 그대로 카메라 재실 이벤트에 싣는다.
    * 게이트웨이: 정리 확인·사진 전송 성공 줄, 실패 뒤 다시 보내기 성공 줄
    센서는 10초마다라 성공 때 조용히, 실패 뒤 성공만 한 줄. 거부 줄에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
2026-11-12 feat(tidy_eval): 정리 확인 시간 목표 10초 → 2분 (#57)
    * feat(tidy_eval): 정리 확인 시간 목표를 사진당 10초 → 2분으로
    퇴실 뒤 한 번만 확인하니 1~2분까지 괜찮고, 시간보다 정확도를 우선한다 (11/11 수연).
    후보 하나 채점 제한(TIDY_TIMEOUT 기본)도 30분 → 3시간으로 늘린다.
    * fix(tidy_eval): 채점 제한 기본값을 문제 수에 맞추고 README 시간 설명 고침
    사진당 2분까지 허용하면 47쌍 × 2장이 3시간을 넘을 수 있어서, 기본값을
    문제 수 × 2장 × 2분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
    [tidy_eval.py]
2026-11-12 게이트웨이: 정리 확인 사진 찍음/없음 로그 (#60)
    * 게이트웨이: 입실 전·퇴실 뒤·3시간 뒤 사진 찍음/없음 로그
    * 사진 없음 로그: 이유를 사람으로 단정하지 않음
    * 사진 없음 로그: 이유 없이 '없음'만
    ---------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
2026-11-12 게이트웨이: 10판 1등(87.2%) 정리 확인을 실제 게이트웨이에 (DESK_MOVE + VLM_URL) (#61)
    * exp: 책상 비교에 SSIM(모양 비교) 방식 추가 (DESK_LIGHT=ssim)
    4회차 채점용 실험 브랜치. 머지하지 않음 (실험 코드는 브랜치에만).
    밝기 차이 대신 자리마다 평균·대비·무늬를 비교해서 빛·그림자 변화를 덜 잡는다.
    (cherry picked from commit 9b0faca333aec49477c1b8f510144c1711431b4d)
    * 게이트웨이: 10판 1등(87.2%) 정리 확인을 실제 게이트웨이에 (DESK_MOVE + VLM_URL)
    - 책상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
2026-11-12 게이트웨이: VLM 기다림 90초 + VLM 요청은 프록시 안 거치게 (#62)
    * 게이트웨이: VLM 기다림을 90초로 (채점은 300초 그대로)
    오래 기다리는 사이 다음 예약이 퇴실하면 core가 앞 예약의 FIRST 결과를 안 받는다 (#61 지영 리뷰).
    90초가 넘으면 VLM 답 없이 YOLO 결과를 보낸다.
    * 게이트웨이: VLM 요청은 환경변수 프록시를 거치지 않게
    urllib 기본 전송은 http_proxy를 따라서, 127.0.0.1로 보내도 no_proxy가 없으면
    사진이 프록시(젯슨 밖)로 갈 수 있다 (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
2026-11-12 게이트웨이: 지금 설정의 시험 점수를 정리 확인과 같이 core에 보내기 (#63)
    * 게이트웨이: 지금 설정의 시험 점수를 정리 확인과 같이 core에 보내기
    관리자 화면의 "모델 시험 정확도 76.6%"가 웹에 하드코딩돼 있어서, 젯슨 채점 기록
    (eval/tidy/results.jsonl)에서 게이트웨이와 같은 설정의 가장 최근 점수를 찾아
    tidy-checks 요청에 model 칸으로 붙인다. 숫자만 보내고, 같은 설정 기록이 없으면 안 보낸다.
    TIDY_RESULTS로 파일을 바꾸거나 off로 끈다.
    Claude-Session: https://claude.ai/code/session_01YAvo4zTU5AiyWQadp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
2026-11-12 정리 확인: 확신도를 "이 이름일 확률" 대신 "물건이 있을 확률"로 (#65)
    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
2026-11-12 feat: 찾으러 온 QR이면 10분 뒤 다시 찍어 RECHECK 보내기 (#68)
    * 찾으러 온 QR(RETRIEVE)이면 다시 확인을 남기고 N분 뒤 빈 방을 다시 찍어 RECHECK
    문 확인기 응답의 purpose를 방 카메라에 전함 (DoorNotifyingVerifier).
    RETRIEVE면 drop_recheck_on_entry를 하지 않고 그 빈 방을 다음 예약 기준으로 쓰지 않음.
    QR + RETRIEVE_RECHECK_MIN(기본 10)분 뒤 빈 방이면 RECHECK. CLEAN이면 끝, 남았으면 3시간 확인 기준 유지.
    그 전에 다른 QR로 열리면 취소.
    * 입실 전 기준을 퇴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
2026-11-12 fix: 찾으러 온 뒤 다시 확인은 방이 빌 때까지 기다리기 (#69)
    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
    [room_camera.py]
2026-11-12 feat: 채점 점수를 core로 보내기 (모델 시험 정확도) (#67)
    * tidy_eval: 채점 점수를 core로 보내기 (model-scores, push-last)
    score가 끝나면 숫자만 POST /api/rooms/{방}/model-scores. SERVER 없거나 DRY_RUN=1이면 body만 출력.
    실패해도 채점 기록은 남기고 한 줄만. results.jsonl에 eventId를 적어 push-last로 같은 id 다시 보내기.
    compare(--json)에서는 보내지 않음.
    * tidy_eval: push-last는 compare 줄 건너뜀, 옛 줄 정확도 대체값, 루프백은 프록시 안 거침 (리뷰)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
2026-11-12 feat: 확신도를 이 사진 기준으로 (YOLO 점수·VLM YES 확률) (#70)
    * feat: 확신도를 채점 표 값 대신 이 사진 기준으로 (YOLO 점수·VLM YES 확률)
    * fix(vlm): top_logprobs가 없으면 YES 확률을 만들지 않음
    * fix: YOLO 물건은 YOLO 점수 그대로, VLM 확률은 바로 돌려받기 (재웅 리뷰)
    Claude-Session: https://claude.ai/code/sess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
    [gateway.py, room_camera.py, vlm_check.py]
2026-11-12 fix: YOLO가 CPU 스레드를 2개만 쓰게 (VLM이 90초 안에 답하도록) (#71)
    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
    [room_camera.py]
2026-11-12 확신도: VLM이 답하면 모든 물건에 '새 물건 있음' 확률 (#72)
    YOLO 점수는 이름이 맞을 확률이라, VLM 답이 있으면 물건마다 VLM 확률을 쓴다.
    VLM 답이 없을 때(RECHECK, 꺼짐, 시간 초과)만 YOLO 점수, 그것도 없으면 0.5.
    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
2026-11-12 3시간 뒤 다시 확인도 VLM에게 묻기 (#73)
    * 확신도: VLM이 답하면 모든 물건에 '새 물건 있음' 확률
    * 3시간 뒤 다시 확인도 VLM에게 묻기 (입실 전 사진을 메모리에 보관)
    첫 확인에서 남은 게 있거나 VLM에게 물었으면 VLM 크기 입실 전 사진을
    recheck_base에 메모리로만 남기고, RECHECK 때 지금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
2026-11-12 다시 켠 뒤 옛 입실 전 기준을 새로 잡고, VLM도 꼭 묻기 (#74)
    - 파일에서 불러온 기준은 다음에 사람이 들어올 때 새 빈 방으로 바꾼다 (예약 47: 옛 기준의 가짜 노트북 때문에 두고 간 노트북을 놓침)
    - QR 직전 사람이 먼저 잡혀 못 쓴 빈 방 후보를 15초 들고 있다가 QR 입실이면 그것으로 기준을 잡는다
    - 메모리에 VLM 사진이 없으면 저장된 입실 전 사진으로 만들어 VLM에게 묻는다
    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
2026-11-12 정리 확인 화면에 물건마다 YOLO 점수 보이기 (서버로는 안 보냄) (#75)
    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
2026-11-12 확신도: VLM이 답해도 YOLO 점수와 VLM 확률 중 높은 값 쓰기 (#77)
    예약 #51에서 VLM은 '없음' 24%, YOLO는 마우스 71%로 결과는 '두고 간 물품'인데
    화면에 24%로 보였다. 물건마다 높은 값을 쓴다.
    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
2026-11-12 채점: VLM 있음 확률을 정답별로 보이기 (camera-warn 기준용) (#76)
    * 채점: VLM 있음 확률을 정답별로 한 장씩 보이고 기록
    * eval: VLM 있음 확률을 소수점 한 자리까지 보여 주기 (80% 근처 구분)
    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
2026-11-12 정리 확인: 조각 수 설정 TILE_GRID (3이면 9조각) (#78)
    * 정리 확인: 조각 수 설정 TILE_GRID (기본 4조각, 3이면 9조각)
    책상 상자(DESK_AREA) 없이 어느 장소에서든 작은 물건을 보는지 채점하려고.
    기본값은 지금과 같다.
    * 조각 수가 다르면 저장된 기준·예약 기준을 쓰지 않기 (CodeRabbit)
    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
2026-11-12 입실: 사람이 10초 넘게 보여야 들어온 것으로 보기 (지나가는 사람) (#79)
    * 입실: 사람이 10초 넘게 이어서 보여야 들어온 것으로 보기
    예약 51(11/12)에서 문 밖을 지나간 사람이 몇 초 찍혀 앞 예약 다시 확인이 취소됐다.
    * 입실: 앉은 사람을 한두 장 놓쳐도 10초를 다시 세지 않기 (0명이 3초 이어져야 지나간 사람)
    * 입실 확정 대기: PIR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
2026-11-12 채점: 사진 비교가 건너뛰었는지·몇 곳 찾았는지 보여 주기 (#80)
    화면 전체 비교(DESK_AREA=0,0,1,1)에서 035·036 가방을 못 찾은 이유가
    사진 비교가 조명 탓으로 건너뛴 것인지 보려고. 판정은 바꾸지 않는다.
    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
2026-11-12 사진 비교: 크게 달라도 작은 변화 보기 · 의자보다 작은 곳은 물건으로 (설정) (#81)
    * 사진 비교: 화면이 크게 달라도 작은 변화는 보기, 의자보다 작은 곳은 물건으로 (설정, 기본 꺼짐)
    DESK_KEEP_SMALL: 35% 넘게 달라져 비교를 건너뛰던 쌍(11/12 1차 11쌍)에서
    큰 변화만 빼고 물건 크기 변화는 계속 본다.
    DESK_FURNITURE_SMALL: 의자로 이름 붙은 변화라도 의자 상자보다 훨씬 작으면
    의자 위·옆 물건으로 센다 (11/12 1차 035 가방).
    둘 다 기본 0이라 지금 동작은 그대로.
    Claude-Session: https://claude.ai/code/se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
2026-11-13 README: 시험 점수 보내기·VLM 90초/캐시·문제집 폴더·11판 기록 (#66)
    * README: 확신도 = 물건이 남아 있을 확률(#65), 시험 점수 보내기(#63), VLM 90초·캐시
    * README: 책상 비교·VLM 확신도도 채점 표 값(없으면 0.5), score 예시에 ~/AI-go-do
    * README: 11판 (develop에서 10판 설정 다시 채점) 기록
    Claude-Session: https: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
2026-11-13 정리 확인: 가구 이름만 붙은 곳은 물건으로 (DESK_FURNITURE_SEEN, 12판 1등) (#82)
    달라진 조각에 가구 이름이 붙어도 화면 전체에서 그 자리에 그 가구가 안 보이면 모르는 물건으로 센다. 기본 꺼짐.
    1차 47쌍 87.2% → 89.4%, 심각 오류 6 → 5. README 12판 기록과 설정 설명 추가.
    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
2026-11-13 정리 확인 사진: 남은 물건 자리에 빨간 동그라미 (#84)
    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
2026-11-13 공간 등록: 새 방에서 처음 빈 방 5분 동안 방 비품을 자동으로 정하기 (#83)
    * 공간 등록: 5분 동안 빈 방을 보고 방 비품(ROOM_ITEMS)을 자동으로 정하기 (room_setup.py)
    새 방에 카메라를 단 뒤 한 번 돌리면 room_profile.json에 비품을 적고, 게이트웨이는 ROOM_ITEMS가 없을 때 그걸 쓴다.
    사람이 보이는 장은 안 쓰고, 80% 이상 장에서 보인 물건만 비품으로. 치울 것이 보이면 등록하지 않음. 사진은 저장·전송 안 함.
    * 공간 등록: 비품을 카메라 켤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
2026-11-13 정리 확인 사진 동그라미: 큰 곳도 화면 안에, 작은 물건은 더 크게 (#85)
    * 정리 확인 사진 동그라미: 큰 곳도 화면 안에, 작은 물건은 더 크게, 덜 쨍한 색
    * 동그라미 색은 그냥 빨강으로 (수연)
    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
2026-11-13 채점: TIDY_MARKS=1이면 문제마다 동그라미 사진과 index.html
    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
2026-11-13 채점 동그라미: 파일 이름을 한 폴더로 펴고 주소는 인코딩, 저장 실패는 알림 (CodeRabbit)
    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
